mrezamostafavi/Sunshine-Recorder/Bachelor's-thesis-Mostafavi.pdf

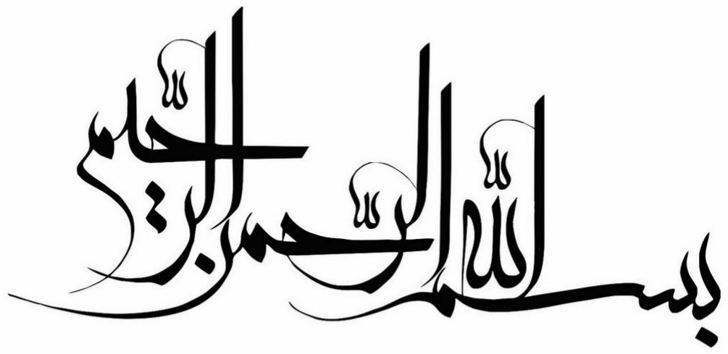
[picture p4: figure]

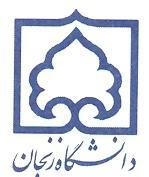
[picture p5: figure]

### پاياننامه کارشناسی

گرايش : الکترونیک

عنوان :
طراحی و ساخت نمونه آزمايشی آفتاب نگار

استاد راهنما : جناب آقای دکتر مهرداد بابازاده

نگارش : محمدرضا مصطفوی

تابستان 1400

# تقدير و تشکر

## شکر شایان نثار ایزد منان که توفیق را رفیق راهم ساخت تا این پایاننامه را به پایان برسانم. از استاد فاضل و اندیشمند جناب آقای دکتر بابازاده به عنوان استاد راهنما که همواره اینجانب را مورد لطف و محبت خود قرار دادهاند، کمال تشکر

را دارم.

خدای را بسی شاکرم که از روی کرم، پدر و مادری فداکار نصیبم ساخته تا در سایه درخت پربار وجودشان بیاسایم و از ریشه آنها شاخ و برگ گیرم و از سایه وجودشان در راه کسب علم و دانش تالش نمایم. والدینی که بودنشان تاج افتخاری است بر سرم و نامشان دلیلی است بر بودنم، چرا که این دو وجود، پس از پروردگار، مایه هستیام بوده اند دستم را گرفتند و راه رفتن را در این وادی زندگی پر از فراز و نشیب به من آموخت ند، آموزگارانی که برایم زندگی، بودن

و انسان بودن را معنا کردند. تقدیم به وجود با ارزششان.

### فهرست مطالب

چکیده 1 |
مقدمه2 |
فصل اول : کلیات تحقی ق 4 |
تاريخچه آفتاب نگار[1]4 |
مزايا و معايب آفتاب نگار کمپبل استوکس 6 |
آفتاب نگار الکتريکی[2]7 |
طرح پیشنهادی 8 |
فصل دوم : تجهیزات مورد استفاده 10 |
بدنه طرح پیشنهادی 10 |
تجهیزات الکترون یکی 15 |
فوتورزيستور15 |
ماژول مالتی پلکسر 16 کاناله16 |
ماژول کارت حافظه17 |
ماژول ساعت 3231DS19 |
آردوينو پرو می نی 20 |
فصل سوم : روش تحقیق 24 |
اتصاالت الکتريکی 24 |
عملکرد کلی پروژه 27 |
برنامه نويسی28 |

حلقه های اصلی28 |
انتخاب برد و پورت28 |
سريال مانیتور 30 |
کتابخانه در آردوينو 31 |
برنامه نوشته ش ده برای آفتاب نگار طراحی شده 32 |
فصل چهارم : يافته های تحقیق 43 |
نتی جه گی ری 46 |
پیشنهادات51 |
مراجع53 |

### فهرست تصاوير

تصویر -1 آفتاب نگار کمپبل استوکس[1]5 |
تصویر -2 نوارها ی استفاده شده در آفتاب نگار کمپبل استوکس6 |
تصویر -3 پیرانومتر[2]8 |
تصویر -4 نمای کلی آفتاب نگار طراح ی شده 9 |
تصویر -5 اجزای بدنه آفتاب نگار طراحی شده 12 |
تصویر -9 فوتورزیستور15 |
تصویر -10 ماژول مالتی پلکسر 16 کاناله 17 |
تصویر -11 ماژول کارت حافظه Card SD18 |
تصویر -12 ماژول ساعت 3231DS19 |
تصویر -13 آردوینو پرو م ینی22 |
تصویر -14 شماتیک آردو ینو پرو مینی[4]23 |
تصویر -15 شماتیک اتصاالت مدار طراحی شده 25 |
تصویر -16 نمایی دیگر از اتصاالت پردازنده و ماژولها25 |
تصویر -17 نحوه اتصال سنسورها و مقاومتها 26 |
تصویر -18 اتصال مالت ی پلکسر به خروج ی سنسورها 26 |
تصویر -19 تکم یل و جداسازی بخش مربوط به سنسورها 27 |
تصویر -20 انتخاب برد آردوینو 29 |
تصویر -21 انتخاب پورت آردوینو29 |
تصویر -22 سریال مانیتور آردوینو30 |
تصویر -23 بخش اول برنامه نوشته شده 32 |
تصویر -24 بخش دوم برنامه نوشته شده33 |
تصویر -25 بخش سوم برنامه نوشته شده 34 |
تصویر -26 بخش چهارم برنامه نوشته شده 35 |

تصویر -27 بخش پنجم برنامه نوشته شده 36 |
تصویر -28 بخش ششم برنامه نوشته شده 37 |
تصویر -29 بخش هفتم برنامه نوشته شده 38 |
تصویر -30 بخش هشتم برنامه نوشته شده 39 |
تصویر -31 بخش نهم برنامه نوشته شده40 |
تصویر -32 بخش دهم برنامه نوشته شده 41 |
تصویر -33 بخش یازدهم برنامه نوشته شده42 |
تصویر -34 نتایج نهایی 16 سنسور43 |
تص ویر -35 نمودار مربوط به سنسورهای 7 و 8 و 15 و 44 | 16
تصویر -36نمونهای از اطالعات نمایش داده شده در سریال مانیتور 45 |
تصویر -37 نمودار مربوط به سنسورهای 7 و 47 | 8

1

### چکیده

با توجه به رو به اتمام بودن منابع انرژی تجدید ناپذیر مانند نفت و گاز و مشکالتی که

استفاده از این انرژیها به وجود آورده است مانند تغییرات اقلیم، آلودگی هوا و تخریب محیط

زیست، استفاده از انواع انرژی تجدیدپذیر ضروری میباشد. انرژی خورشیدی میتواند به طور

مستقیم از خورشید و حتی در آب و هوای ابری به دست آید. انرژی خورشیدی، در سطح

جهان و به صورت گسترده برای تولید برق، گرما و شیرین سازی آب مورد استفاده قرار

میگیرد.

برای اندازهگیری میزان تابش خورشید از دستگاه هایی به نام آفتاب نگار استفاده

میشود. این دستگاهها از گذشته تا کنون شامل تغییرات زیادی شدهاند بگونهای که از شکل

یک کرهی شیشهای به یک دستگاه الکتریکی شامل سنسور رسیده است.

آفتاب نگار طراحی شده شامل 16 سنسور فوتورزیستور است که دور یک حجم گنبدی

شکل قرار داده شدهاند. اطالعات دریافتی از سنسورها با زمان وقوع آنها، از طریق ماژول ها و

قطعات مورد نیاز درون یک کارت حافظه ذخیره میشوند و همچنین به صورت لحظهای

نمایش داده میشوند.

با بررسی اطالعات بدست آمده متوجه دقت مناسب سیستم طراحی شده میشویم،

بهطوری که میتوان تحلیلهای اولیه راجع به وضعیت آب و هوا و میزان روشنایی هوا در روز

آزمایش و همچنین مسیر حرکت خورشد را ارائه نمود.

2

### مقدمه

گستردگی نیاز انسان به منابع انرژی همواره از مسائل اساسی مهم در زندگی بشر بوده

و تالش برای دستیابی به یک منبع تمام نشدنی انرژی از آرزوهای دیرینه انسان بوده است. به

دلیل افزایش روزافزون نیاز به انرژی و محدودیت منابع فسیلی از یک سو و افزایش آلودگی

محیط زیست ناشی از سوزاندن این منابع از سوی دیگر، استفاده از انرژی های تجدیدپذیر را

روز به روز با اهمیتتر و گستردهتر نموده است.

انرژی خورشیدی، نور و گرمای تولید شده توسط خورشید است. انرژی ستاره خورشید

یکی از منابع عمده انرژی در منظومه شمسی میباشد. طبق آخرین برآوردهای رسمی اعالم

شده عمر این انرژی بیش از 14 میلیارد سال میباشد. در هر ثانیه 2.4 میلیون تن از جرم

خورشید به انرژی تبدیل میشود. با توجه به وزن خورشید که حدود 333 هزار برابر وزن زمین

است، این کره نورانی را میتوان به عنوان منبع عظیم انرژی تا 5 میلیارد سال آینده به حساب

آورد.

سالهای زیادی است که اکثر صنعت جهان روی سوخت های فسیلی )زغال سنگ،

نفت و گاز طبیعی( پایدار است. سوختهای فسیلی منابع تجدید ناپذیر هستند، یعنی به وجود

آمدن آنها نیازمند سالهای زیادی است. بنابراین این سوخت ها مدت زیادی نمیتوانند

جوابگوی تمام نیازهای انسان باشند و یک روز تمام خواهند شد. پس باید جایگزین مناسبی

برای این سوخت ها پیدا شود، که انرژی خورشیدی میتواند جایگزین بسیار مناسبی به خصوص

برای نسلهای آینده باشد. بعضی از انرژیها ت أثیر بد و نامطلوبی بر محیط خواهند داشت،

3

مانند سوخت های فسیلی. با بهرهگیری از انرژی خورشیدی، دیگر جای نگرانی نخواهد بود زیرا

اگر منابع انرژی موجود به اتمام برسند، انرژی تجدیدپذیر و دائمی مانند انرژی خورشیدی را

تا ابد خواهیم داشت و تأ ثیرات مخرب زیست محیطی و ایمنی از نظر سالمتی، بشر را تهدید

نخواهد کرد. همچنین خورشید برای زمینه های مختلف به عنوان یک منبع گرمایی و انرژی

استفاده میشود. پرورش محص والت کشاورزی، گرم کردن، خشک کردن مواد غذایی، ذخیره

کردن انرژی در صفحات خورشیدی، نمونهای از این کاربردها هستند.

اولین قدم در راستای استفاده از انرژیهای تجدیدپذیر پس از شناخت آن ها، توانایی

اندازهگیری و همچنین انتخاب محل مناسب جهت بهره برداری حداکثری از آنها است. امروزه

ابزار اندازهگیری مختلفی برای اندازهگیری این انرژیها موجود است که یکی از آنها آفتاب

### 1 نگار

است، که میزان تابش آفتاب را در هر زمان و در یک مکان یا منطقه خاص اندازهگیری

و ثبت میکند.

1
Sunshine Recorder

4

### فصل اول : کلیات تحقیق

تاريخچه آفتاب نگار [1]

### 1 آفتاب نگار کمپبل استوکس

، یکی از انواع آفتاب نگار است. این وسیله نخستین بار

### 2 توسط جان فرانسیس کمپبل

در سال 1853 اختراع و توسط جرج گابریل استوکس

3
در

سال 1879 اصالح شد. طرح اولیه که توسط کمپبل ارائه شده بود؛ متشکل از یک کره شیشهای

بود که درون یک کاسه چوبی قرار گرفته و خورشید با سوزاندن روی کاسه اثر میگذاشت.

اصالح استوکس این بود که نگهدارندهی کره را از فلز ساخت و یک نگهدارنده نوار را در پشت

کره قرار داد تا با سوزانده شدن نوارها بتوان به مدت زمانی که خورشید در آسمان تابیده است،

پی برد. این دستگاه با ایجاد رد سوختگی روی نوار، مدت تابش آفتاب را ثبت میکند.

این وسیله تشکیل شده از یک گوی شیشهای که عملکردی مانند ذرهبین دارد و پرتو

آفتاب را روی صفحهای که در پشت آن قرار دارد متمرکز میکند. محفظه شیشهای کروی

محتوی آب است که خود محفظه در داخل یک کاسه چوبی قرار دارد، محفظه پرتوهای نورانی

خورشید را شبیه به یک عدسی جمع کرده و روی جدار داخلی کاسه چوبی میاندازد. چوب

)یا نوار آفتاب نگار( در اثر پرتو متمرکز شده و گرمای به دس ت آمده از خورشید سوخته و به

تدریج خطی روی آن کشیده میشود.

1 | Campbell–Stokes recorder
2 | John Francis Campbell
3 George Gabriel Stokes

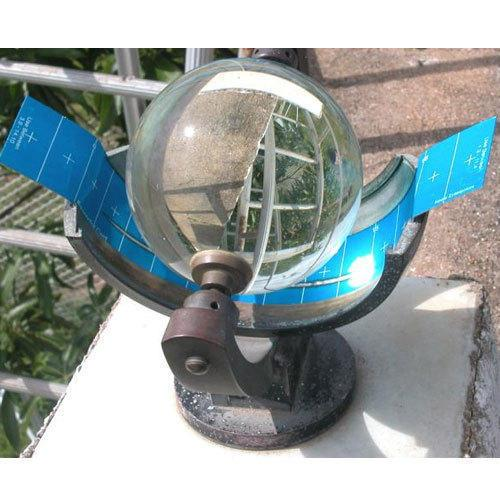
[picture p6: figure]

5

این وسیله رو به جنوب و به صورت کامالً تراز افقی و در ارتفاع 1.5 متری نصب شده

و سپس متناسب با عرض جغرافیایی محل نصب تنظیم میگردد. با توجه به این که در طول

سال زاویه تابش خورشید و طول روز تغییر میکند ، از گرافهای متفاوتی استفاده میشود.

تصویر -1 آفتاب نگار کمپبل استوکس[1]

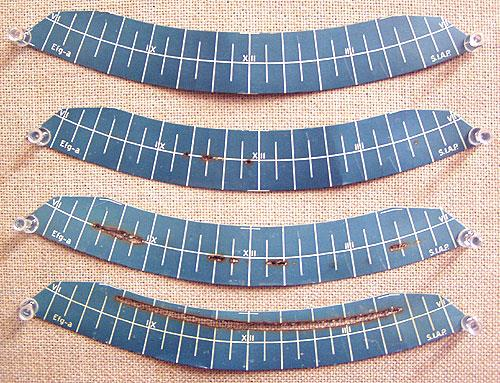
[picture p7: figure]

6

تصویر -2 نوارهای استفاده شده در آفتاب نگار کمپبل استوکس

مزايا و معايب آفتاب نگار کمپبل استوکس

عمدهترین مزیت این نوع آفتاب نگار، سادگی و سهولت استفاده از آن است. هیچ

قسمت متحرکی ندارد، بنابراین به تعمیر و نگهداری بسیار کمی نیاز دارد. این آفتاب نگار را

میتوان در هر کجای دنیا با کمترین تغییر مورد استفاده قرار داد. همچنین این نوع آفتاب

نگار فقط از انرژی خورشیدی استفاده میکند.

هنگامی که تابش خورشید ضعیف باشد، ممکن است قدرت کافی برای سوزاندن

مناسب نوار آفتاب نگار فراهم نشود. این اتفاق اغلب هنگام سحر و غروب رخ میدهد. ممکن

است باران موجب خیس شدن نوار شود و هنگام برداشتن پاره شود و در نتیجه خواندن آن با

7

مشکل مواجه شود. این نوع آفتاب نگار همچنین به عوامل خارجی دیگری همچون گرد و غبار،

آلودگی یا ف ضوالت خشک شده پرندگان روی کره شیشهای و ... حساس است که نیاز به

بازرسی و تمیز کردن مکرر دارد.

آفتاب نگار الکتريکی[2]

همانطور که اشاره شد هنگام استفاده از آفتاب نگار کمپبل استوکس، نیاز است که یک

فرد هر روز نوار استفاده شده را برداشته و تعویض نماید. ممکن است خواندن این نوارها بنا به

دالیل گفته شده در قسمت قبل، با مشکل مواجه شود. همچنین ذخیره کردن تعداد باالی

این نوارها و دسترسی دوباره به آنها کار مشکلی خواهد بود که نیازمند صرف زمان و هزینه

اضافی است. برای حل این مشکالت میتوان از آفتاب نگارهای الکتریکی استفاده نمود. این

نوع آفتاب نگارها برخالف آفتاب نگارهای معمولی که فقط با انرژی خورشیدی کار میکردند،

به یک منبع تغذیه خارجی نیاز دارند.

از جمله این نوع آفتاب نگارها که امروزه مورد استفاده قرار میگیرد میتوان به

### 1 پیرانومتر

اشاره نمود. بطور کلی از پیرانومترها بیشتر برای تحقیقات اقلیمی و اهداف نظارت

بر آب و هوا استفاده میشد، اما عالقه اخیر جهانیان به انرژی خورشیدی، باعث افزایش عالقه

به پیرانومترها شده است.

1 pyranometer

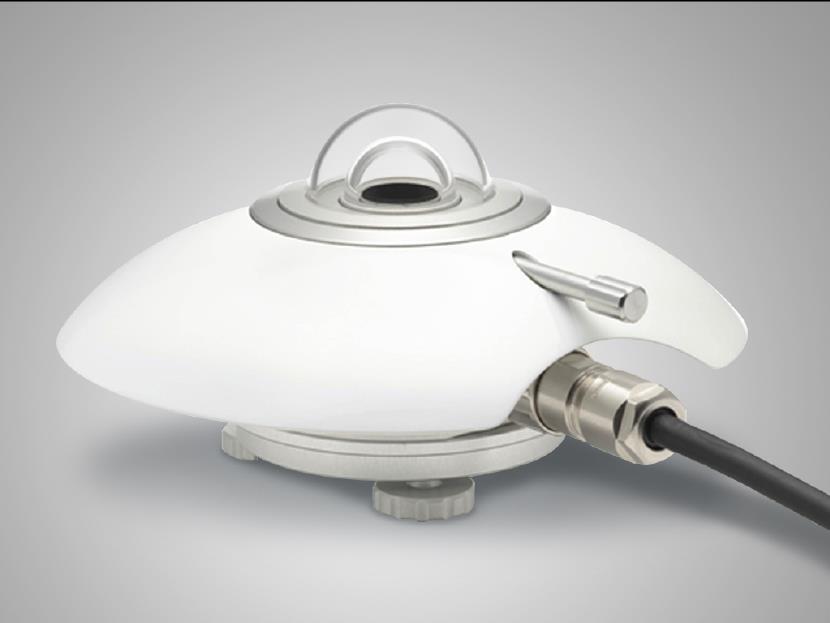
[picture p8: figure]

8

تصویر -3 پیرانومتر[2]

طرح پیشنهادی

همانطور که در بخش های قبل ذکر شد، آفتاب نگارهای الکتریکی مزیتهای بیشتری

نسبت به آفتاب نگارهای معمولی دارند و همچنین قابلیتهای بیشتری نیز می توان به آنها

اضافه نمود. طرحی که در این مطلب به آن پرداخته خواهد شد هم در مجموعه آفتاب نگارهای

الکتریکی قرار میگیرد. مهمترین مزیتی که این طرح را از آفتا ب نگارهای الکتریکی موجود

متمایز میکند، پایین بودن هزینه تمام شده این طرح نسبت به مدلهای دیگر است. در این

طرح سعی بر این بوده است که از سنسورها و قطعات الکترونیکیای استفاده شود که عالوه بر

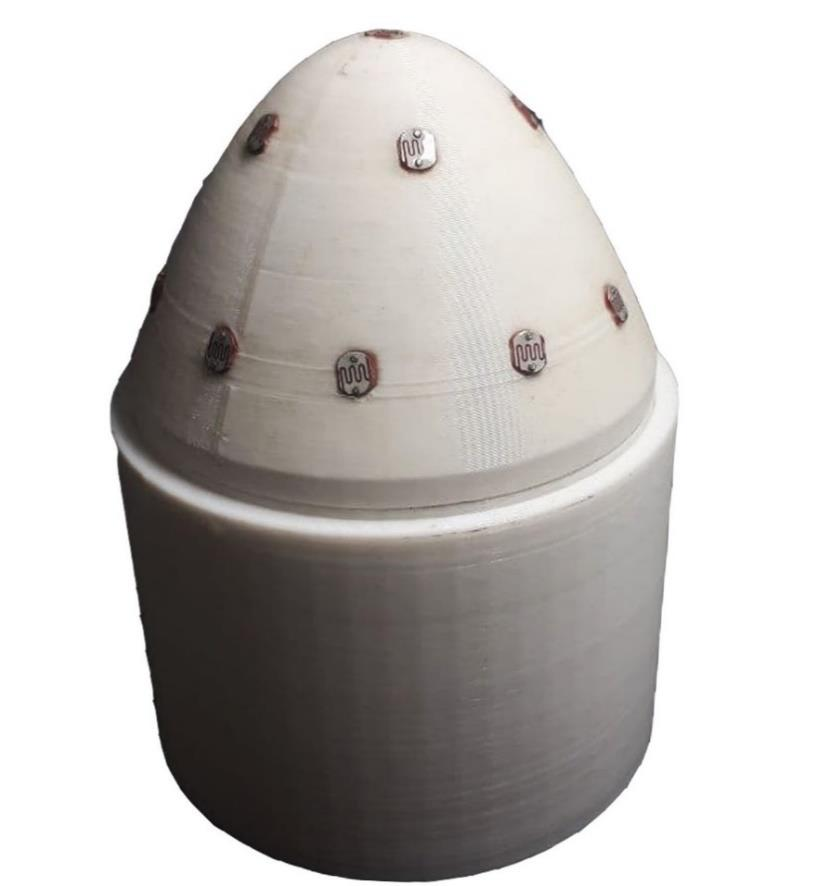
[picture p9: figure]

9

داشتن قیمت پایین، به آسانی قابل دسترس بوده و همچنین از دقت مناسبی نیز برخوردار

باشند. امکان به کارگیری این طرح در تمامی نقاط کره زمین، از جمله اهداف دیگر این طرح

است.

تصویر -4 نمای کلی آفتاب نگار طراحی شده

10

### فصل دوم : تجهیزات مورد استفاده

بدنه طرح پیشنهادی

آفتاب نگار طراحی شده از دو بخش مجزا تشکیل شده است، بخش مربوط به قرارگیری

و اتصاالت سنسورها و بخش مربوط به تجهیزات الکترونیکی که کار پردازش و ذخیره اطالعات

را برعهده دارند. از دالیل جداسازی این دو بخش میتوان به کم کردن اتصاالت نهایی به

پردازنده اصلی و همچنین ایجاد سهولت در تعویض یا تعمیر هر یک از بخشها بدون نیاز به

تغییر در بخش دیگری اشاره نمود.

1 | ابتدا بدنه در نرم افزار سالیدورک
طراحی و سپس با استفاده از پرینترهای سهبعدی،
3 | های PLA | 2 | ساخته شد. برای ساخت بدنه از فیالمنت
که رایج ترین نوع فیالمنت مصرفی در

پرینترهای سهبعدی است، استفاده شده است. PLA، نوعی ترموپالست است که از مواد

ارگانیک نظیر ساقه ذرت و نیشکر تولید میشود. این بنیان طبیعی PLA باعث شده تا موقع

پرینت هیچگونه بوی بدی تولید نکرده، بخار آن سمی نبوده و در پایان با راحتی بیشتری قابل

بازیافت باشد. پرینت PLA به مراتب از دیگر متریالهای فیالمنتی راحت تر است و این نکته

مهمترین دلیل حضور پررنگ این متریال در بازار مواد مصرفی است. از جمله دالیل دیگر که

باعث رایج شدن این نوع فیالمنت شده است، قیمت کمتر و همچنین چاپ آسان و بی دردسر

آن نسبت به انواع دیگر فیالمنتها است.

1
Solidwork

2
Filament
3 Poly Lactic Acid

11

1 | فیالمنت ABS
یکی دیگر از مواد مصرفی رایج در بازار پرینترهای سهبعدی است.

ABS در عین ارزانتر بودن نسبت به بقیه متریالها، دارای استحکام خوبی بوده و نسبت به

فیالمنت PLA منعطفتر است. همین امر باعث شده تا در استفاده نهایی و قرارگیری در

کاالهای مصرفی نقش بیشتری داشته باشد. دو موضوع مهم وجود دارد که بسیاری از کاربران

را از مصرف این نوع فیالمنت باز میدارد. یکی سمی بودن بخار ناشی از ABS در حین چاپ و

دیگری فرایند چاپ آن، که معموال در مقایسه با PLA کمی چالشیتر بوده و نیازمند تجربه

2 | است. شایان ذکر است که حالل ABS، استون
میباشد و می توان از این خاصیت حاللی جهت

پرداخت و پولیش سازه های چاپ شده استفاده کرد. در حالی که حالل PLA ماده سمی

3 کلروفرم

است. این که میبینیم در بازار مواد مصرفی، معموالً PLA پرطرفدارتر از ABS است،

به دلیل استفاده راحتتر و متنوعتر بودن PLA است. تقریباً همه پرینترهای سهبعدی ساخته

شده در دنیا میتوانند PLA را پرینت کنند اما این موضوع برای ABS صادق نیست. [3]

قطعات پرینت شده این طرح از جنس فیالمنت PLA سفید رنگ، در تصویر 4 به

نمایش درآمده است.

1 Acrylonitrile Butadiene Styrene 2 Acetone
3 Chloroform

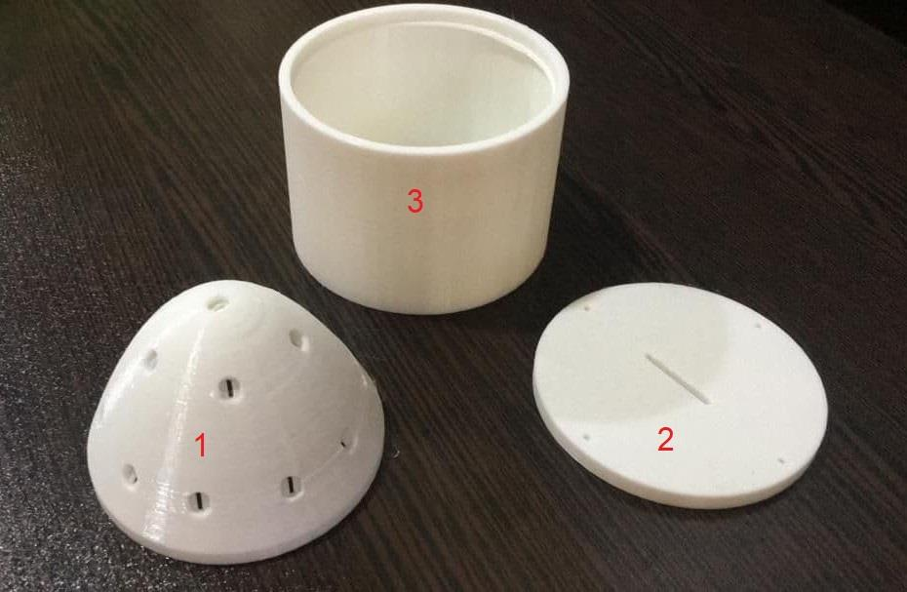
[picture p10: figure]

12

تصویر -5 اجزای بدنه آفتاب نگار طراحی شده

با توجه به تصویر ،5 قطعهای که با شماره 1 مشخص شده است مربوط به بخش

قرارگیری و اتصاالت سنسورها است. روی این قطعه 16 حفره برای قرارگیری سنسورها در

داخل آنها وجود دارد که یکی از این حفره ها در رأس این گنبد و مابقی دور تا دور آن ایجاد

شدهاند که با یکدیگر 24 درجه فاصله دارند. همانطور که مشاهده میشود این قطعه به صورت

سهمیگون است، درحالی که اگر بصورت نیم کره طراحی میگردید ارتفاع قطعه پایین آمده

و سنسورها به هم نزدیک تر میشدند و در نتیجه تفکیک اطالعات آنها دشوار میشد و برای

زیاد کردن فاصله بین آنها باید قطر این نیم کره افزایش پیدا میکرد که نتیجهای جز افزایش

حجم کلی دستگاه نداشت. قطعهای که با شماره 2 مشخص شده است، به زیر قطعه شماره 1

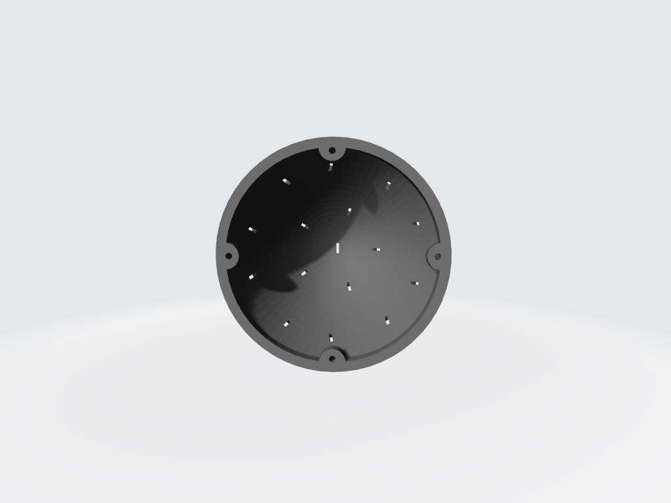
[picture p11: figure]

13

متصل میشود تا آن را از قطعه شماره 3 جدا کند. در این قطعه یک حفرهای وجود دارد تا از

آنجا 8 پایه خارج شود که بتوان اطالعات سنسورها را توسط آنها دریافت کرد. همچنین این

قطعه وظیفه اتصال قطعه شماره 1 با قطعه شماره 3 را به عهده دارد. قطعهای که با شماره 3

مشخص شده است، محل قرارگیری تجهیزات الکترونیکی و ذخیره کننده اطالعات است.

تصویر -6 نمای داخلی قطعه شماره 1

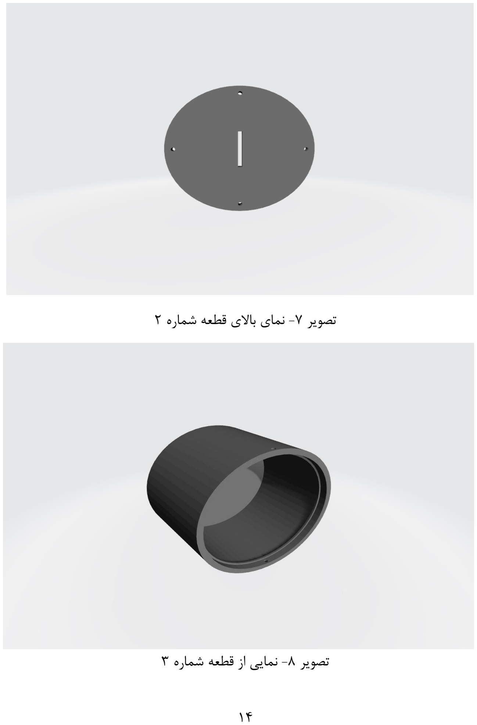
[picture p12: page 21]

14

تصویر -7 نمای باالی قطعه شماره 2

تصویر -8 نمایی از قطعه شماره 3

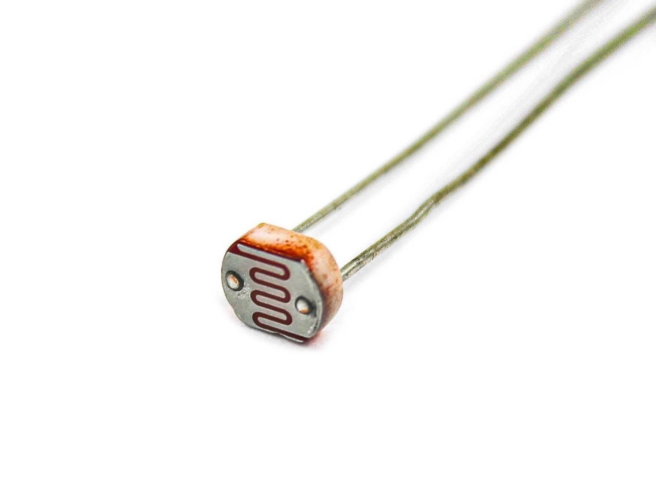
[picture p13: figure]

15

تجهیزات الکترونیکی

1 | فوتورزيستور

سنسورهای فوتورزیستور نوعی از مقاومتها هستند. همانگونه که از اسم آن میتوان

فهمید، به نور حساس است و با تغییر میزان نور مقدار مقاومت نیز تغییر میکند. با روشنتر

شدن محیط اطراف فوتورزیستور، مقدار مقاومت کاهش یافته و با کاهش نور مقدار مقاومت

افزایش مییابد. مشخصه ی خروجی این سنسور به صورت غیرخطی است.

تصویر -9 فوتورزیستور

1 Photoresistor

16

ماژول مالتی پلکسر 16 کاناله

از ماژول مالتی پلکسر 16 کاناله 4067HC74CD میتوان برای زمانی که تعداد زیادی

ورودی آنالوگ در یک مدار وجود دارد، استفاده کرد. در این حالت نیاز است در هر زمان یکی

از آن ورودیها انتخاب شده و پردازش شوند. از این مالتی پلکسر میتوان برای انتخاب از بین

16 ورودی آنالوگ استفاده کرد. برای این منظور 4 پایه 0-3S تعبیه شدهاند که با دادن مقادیر

مناسب به آنها یکی از ورودیهای آنالوگ انتخاب شده و در پایه SIG به عنوان خروجی قرار

میگیرد.

ماژول مالتی پلکسر 16 کاناله 4067HC74CD دارای 24 پایه به شرح زیر است:

- VCC : تغذیه ماژول )5 ولت(
- GND : زمین
- EN : پایه فعال ساز )این پایه Low Active است.(
- 0-3S : انتخاب یکی از 16 پایه ورودی آنالوگ به عنوان سیگنال خروجی نهایی
- 0-15C : ورودیهای آنالوگ
- SIG : سیگنال خروجی

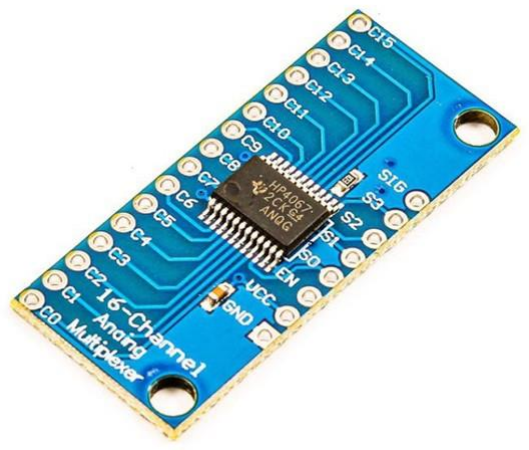
[picture p14: figure]

17

تصویر -10 ماژول مالتی پلکسر 16 کاناله

ماژول کارت حافظه

با استفاده از ماژول کارت حافظه میتوان با کارت حافظه ارتباط برقرار کرد و اطالعات

1 | مورد نظر را از آن خواند و یا بر روی آن نوشت. ارتباط این ماژول از طریق پروتکل SPI

میباشد. حداکثر ظرفیت قابل شناسایی این ماژول برای کارت حافظه مدلSD، دو گیگابایت

و برای مدل SD-Micro، شانزده گیگابایت است. همچنین ماژول کارت حافظه قابلیت استفاده

1
Serial Peripheral Interface

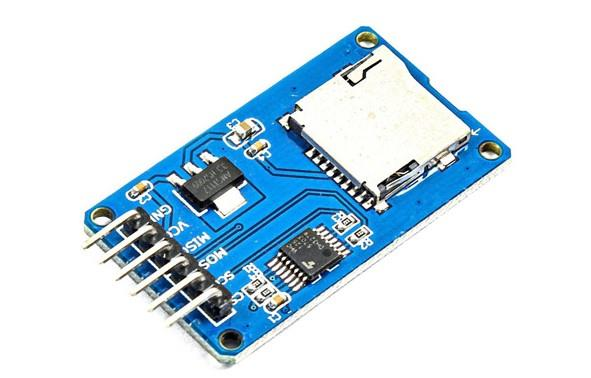
[picture p15: figure]

18

برای کارتهای SD-Micro و SDHC-Micro را دارد و دارای یک رگوالتور 3.3 ولت است

که ولتاژ پایه ها برای اتصال به کارت حافظه را به 3.3 ولت کاهش میدهد.

این ماژول دارای 6 پایه به شرح زیر است:

- VCC : تغذیه ماژول )5 ولت(
- GND : زمین

ChipSelect پایه : CS •

- MISO : پایه فرستنده – معادل پایه Tx پورت سریال
- MOSI : پایه گیرنده – معادل پایه Rx پورت سریال
- SCK : پایه کالک ماژول

تصویر -11 ماژول کارت حافظه Card SD

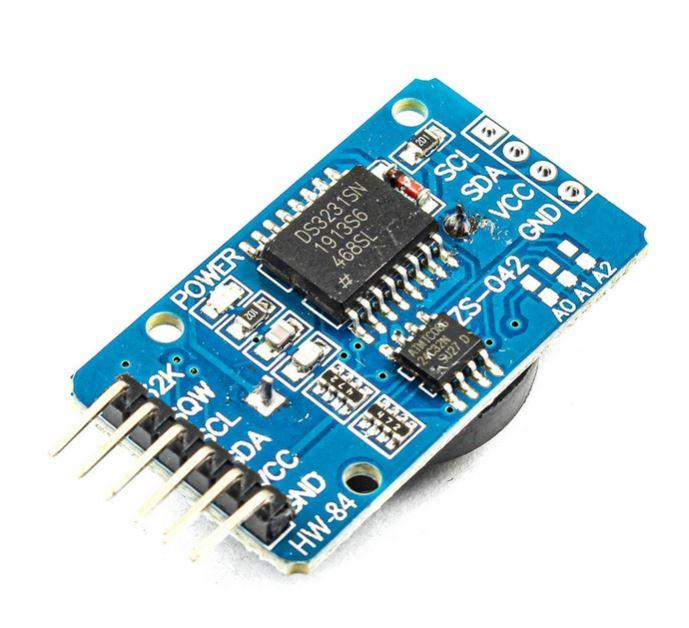
[picture p16: figure]

19

ماژول ساعت 3231DS

ولتاژ کاری این ماژول 3.3 الی 5 ولت بوده و از باتری پشتیبان و جریان مصرفی بسیار

پایین استفاده میکند. باتری پشتیبان قرار گرفته بر روی این ماژول زمانی که برق در دسترس

نیست، از عقب افتادن زمان جلوگیری خواهد کرد. منبع کالک این ماژول از یک کریستال

ساعت به فرکانس 32.768 کیلوهرتز استفاده میکند. این ماژول قابل کارکرد در دو حالت 24

ساعته و 12 ساعته را دارد. همچنین عالوه بر ساعت بصورت ثانیه، دقیقه، ساعت امکان ذخیره

تاریخ بصورت روز، هفته، ماه، سال را نیز دارد.

تصویر -12 ماژول ساعت 3231DS

20

1 | آردوينو پرو مینی

آردوینو، یک پلتفرم متن باز است که در ساخت پروژههای الکترونیکی مورد استفاده

قرار میگیرد. با توجه به طراحی متن باز این پلتفرم، نرمافزار و طرح سختافزار آن به صورت

آزاد در اختیار تمام افراد قرار گرفته و افراد میتوانند به وسیله آن پروژه های الکترونیکی خود

را به سادگی انجام دهند. این ویژگی پلتفرم آردوینو باعث شده تا افراد زیادی در سراسر جهان

از این پلتفرم استفاده کنند و روز به روز بیشتر آن را توسعه دهند. مزیتی که به واسطه رایگان

بودن پلتفرم آردوینو به وجود آمده این است که معموالً هر کسی در هر کجای جهان یک مدار

مکمل به نام شیلد، برای انجام یک کار خاص در آردوینو طراحی میکند و معم والً کتابخانهای

برای این شیلد مینویسد و اغلب اوقات این کتابخانه ها به صورت رایگان با سایر افراد به اشتراک

گذاشته میشود. این ویژگی منحصر به فرد باعث شده تا هر ماژول، سنسور یا قطعهای قابلیت

اتصال به آردوینو را داشته و بتوان صدها کتابخانه برای آن پیدا کرد.

آردوینو شامل یک مدار قابل برنامهریزی فیزیکی )اغلب به عنوان یک میکروکنترلر( و

یک قطعه نرمافزاری یا محیط یکپارچه توسعه )IDE )است که بر روی کامپیوتر اجرا میشود.

IDE ²

محیطی عمدتاً گرافیکی است که تمام یا شماری از ابزارهای الزم برای توسعه نرمافزار

را در خود دارد. در IDE، دسترسی به ابزارها و اعمال آنها در پروژه جاری تسهیل شده است.

برد های آردوینو در بین افرادی که در حوزه الکترونیک فعالیت میکنند بسیار محبوب است.

1 Arduino Pro Mini

2
Integrated Development Environment

21

به این دلیل که برخالف بسیاری از بردهای قابل برنامهریزی، آردوینو برای بارگذاری کدهای

جدید بر روی برد، به سختافزار جداگانه نیاز ندارد و میتوان به راحتی با استفاده از یک کابل

USB این کار را انجام داد.

آردوینو پرو مینی یک برد آردوینو بر پایه میکروکنترلر 328ATmega میباشد و به

لحاظ کارایی و عملکرد کامال مشابه با سایر بردهایی که از این نوع میکروکنترلر استفاده

میکنند بوده و تنها تفاوت این برد در شکل فیزیکی آن میباشد. در این برد به منظور کاهش

سایز ورودی آداپتور و پورت USB( که در اکثر پروژه ها کاربرد دائمی نداشته( حذف شده

است. در نتیجه برای انجام پروژههایی با سایز کوچک و همین طور در رباتهای پرنده و یا

هواپیماهای مدل که وزن و اندازه اجزای آن بسیار حائز اهمیت است، توصیه میگردد. از طرفی

حذف پورت USB در این مدل برد موجب شده تا نتوان به سادگی سایر بردهای آردوینو، کدها

را بر روی برد آپلود نمود و برای این کار الزم است کد را از طریق کابلها و مبدلهای USB

به سریال و یا از طریق یک برد آردینو دیگر که دارای رابط USB میباشد به عنوان پروگرامر

استفاده نموده و کدها را درون میکروی برد آپلود کرد.

از دالیل انتخاب این برد برای آفتاب نگار طراحی شده، میتوان به قیمت پایین آن و

همچنین ابعاد کوچک آن اشاره نمود که تمامی وِیژگیهای الزم برای این پروژه را شامل

میشد و همچنین از قطعات اضافی که روی بردهای دیگر وجود دارد و در این پروژه ضروری

نبود صرف نظر شده است.

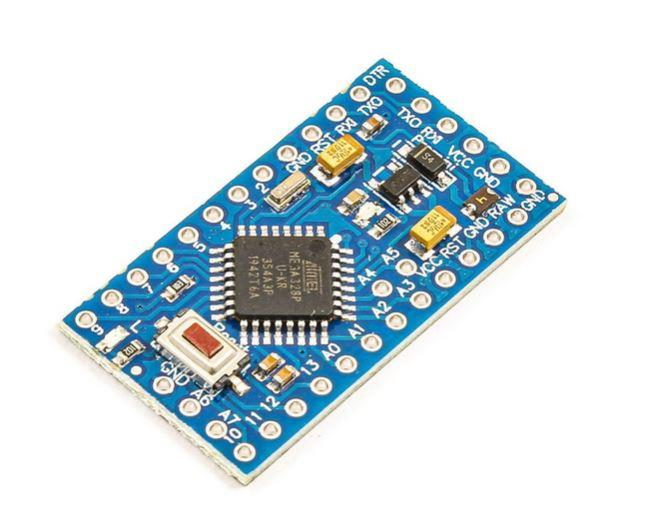
[picture p17: figure]

22

مشخصات فنی آردوینو پرو مینی :

- ولتاژ کاری برد : 3.3 ولت
- پین های ورودی/خروجی دیجیتال : 14
- پین ه ای ورودی/خروجی آنالوگ : 8
- جریان DC هر پین ورودی/خروجی : 40 میلی آمپر
- فرکانس کالک : 8 مگاهرتز

تصویر -13 آردوینو پرو مینی

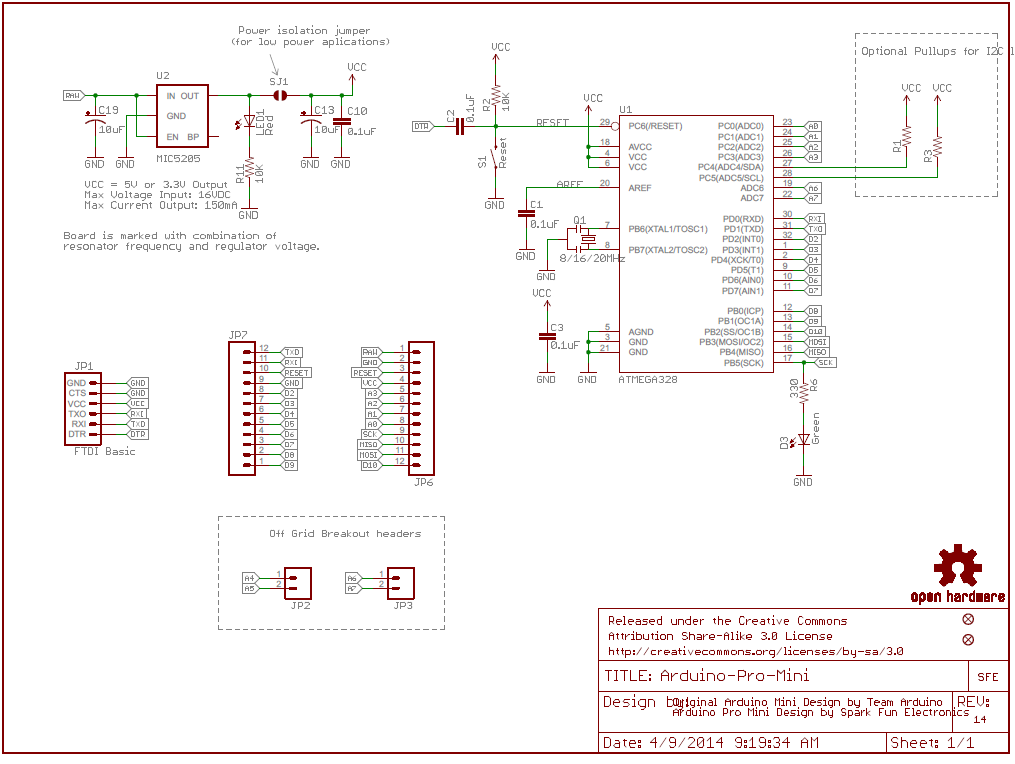
[picture p18: figure]

23

تصویر -14 شماتیک آردوینو پرو مینی[4]

24

### فصل سوم : روش تحقیق

اتصاالت الکتريکی

برای خواندن مقدار فوتورزیستورها، از تقسیم ولتاژ استفاده میکنیم. به این گونه که

یک پایه فوتورزیستور را به VCC و پایه دیگر آن را توسط یک مقاومت 1 کیلو اهم به زمین

متصل میکنیم. از محل اتصال فوتورزیستور و مقاومت مقدار ولتاژ را توسط پایه آنالوگ

پردازنده میخوانیم. با توجه به این که در آفتاب نگار طراحی شده از 16 فوتورزیستور استفاده

شده، اگر بخواهیم همه ولتاژهای تولید شده از این تعداد سنسورها را مستقیماً به پردازنده

متصل کنیم، اوالً باید پردازندهای انتخاب شود که این تعداد پایه آنالوگ داشته باشد که مستلزم

صرف هزینه بیشتری خواهد بود و ثانیاً با توجه به اینکه محل قرارگیری سنسورها از پردازنده

فاصله دارند، نیازمند فضای بیشتری بود و همچنین کنترل آنها به دلیل درهم پیچیده شدن

اتصاالت ، دشوار میشد. برای جلوگیری از معضالت ذکر شده، از مالتی پلکسر 16 کاناله استفاده

شده است که با مقداردهی به پایههای کنترلی آن میتوان تمام خروجی سنسورها را در نهایت

توسط یک پایه به پردازنده انتقال داد. استفاده از مالتی پلکسر به کاهش ابعاد طرح و همچنین

کنترل بهینه آن کمک شایانی کرده است.

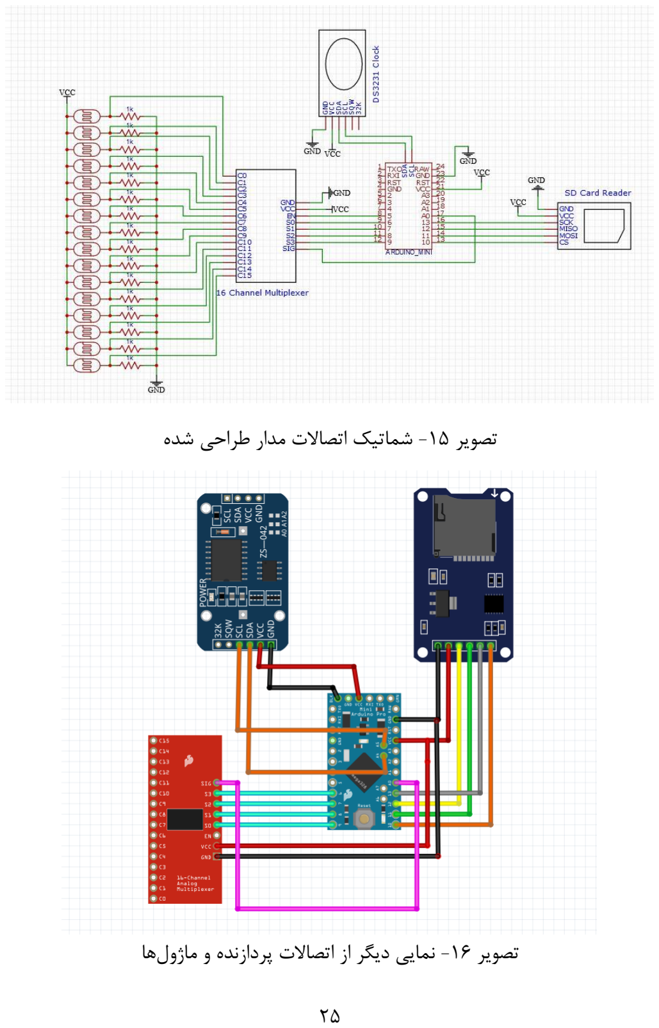
[picture p19: page 32]

25

تصویر -15 شماتیک اتصاالت مدار طراحی شده

تصویر -16 نمایی دیگر از اتصاالت پردازنده و ماژولها

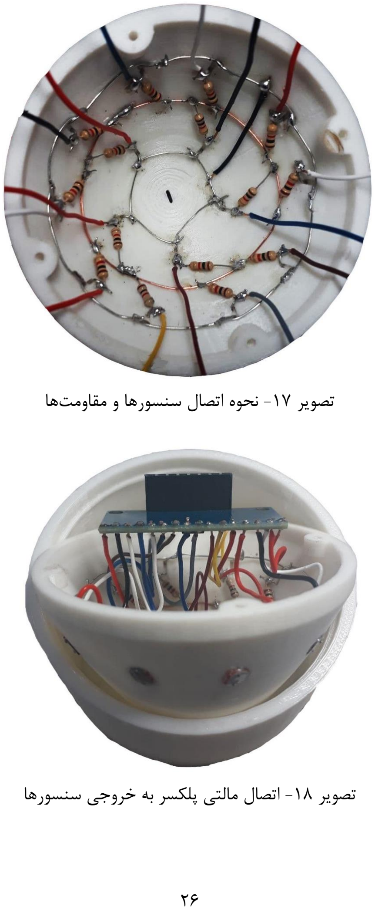
[picture p20: page 33]

26

تصویر -17 نحوه اتصال سنسورها و مقاومت ها

تصویر -18 اتصال مالتی پلکسر به خروجی سنسورها

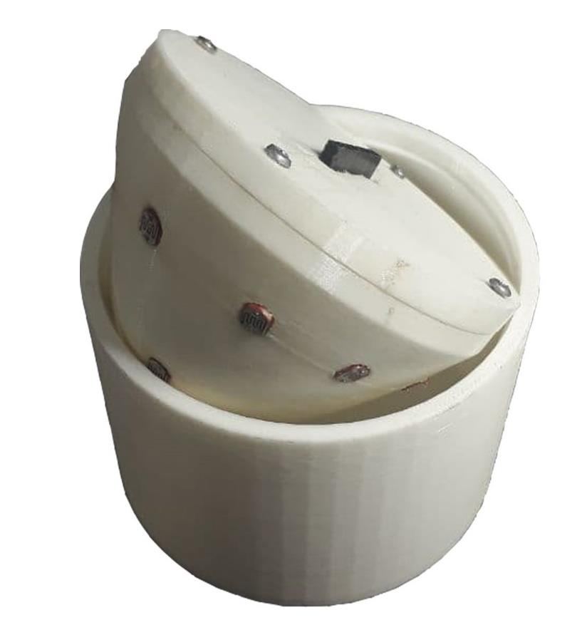
[picture p21: figure]

27

تصویر -19 تکمیل و جداسازی بخش مربوط به سنسورها

عملکرد کلی پروژه

هدف از این سیستم، نمونه برداری از مقدار روشنایی محیط توسط خورشید در

زمانهای مختلف از یک شبانه روز است. هرچه تعداد این نمونهها بیشتر باشد، در نتیجه فاصله

زمانی بین نمونهها کمتر بوده و دادههای نهایی از دقت بیشتری برخوردار خواهند بود. کارکرد

این طرح به این گونه است که هرچند دقیقه یکبار )با توجه به دقت مورد نیاز( اطالعات همه ی

16 سنسور به نوبت توسط مالتی پلکسر به پردازنده انتقال داده شده و همراه با ساعت و دقیقه

آن لحظه که توسط ماژول ساعت دریافت میشود، توسط ماژول کارت حافظه در کارت حافظه-

ای که درون آن قرار گرفته ذخیره میشود و در سریال مانیتور نمایش داده میشوند.

28

برنامه نويسی

با توجه به اینکه از آردوینو به عنوان سیستم پردازنده استفاده شده است، بهترین

انتخاب برای برنامه نویسی زبان C و همچنین در محیط IDE Arduino خواهد بود.

حلقه های اصلی
1 | در آردوینو به هر برنامه، یک طرح

گفته میشود. مبنای کدنویسی آردوینو زبان C و

++C است که برای راحتی کار با آن، تا حد زیادی سادهسازی شده است. یک برنامه آردوینو

حداقل شامل دو بخش کلی Setup Void و Loop Void است. در ادامهی هر کدام از این

بخشها دو آکوالد وجود دارد. محتوای هر کدام از این بخشها بین این دو آکوالد تعریف

میشود. Setup مجموعهای از کدها را دربر میگیرد که هر وقت آردوینو به برق متصل شود

یا کلید Reset فشرده شود، تنها یک بار اجرا میشود. Loop مجموعهای از کدها را در خود

دارد که باید بدون وقفه و به صورت تکراری اجرا شوند.

انتخاب برد و پورت
هر زمان که یک برد آردوینو به رایانه متصل شود، قبل از هر چیز باید برد و پور ت

مورد استفاده را به برنامه معرفی کرد. برای این منظور از مسیر Board → Tools مدل و از

مسیر Port → Tools پورتی که آردوینو به آن متصل شده است، انتخاب میشود.

1
Sketch

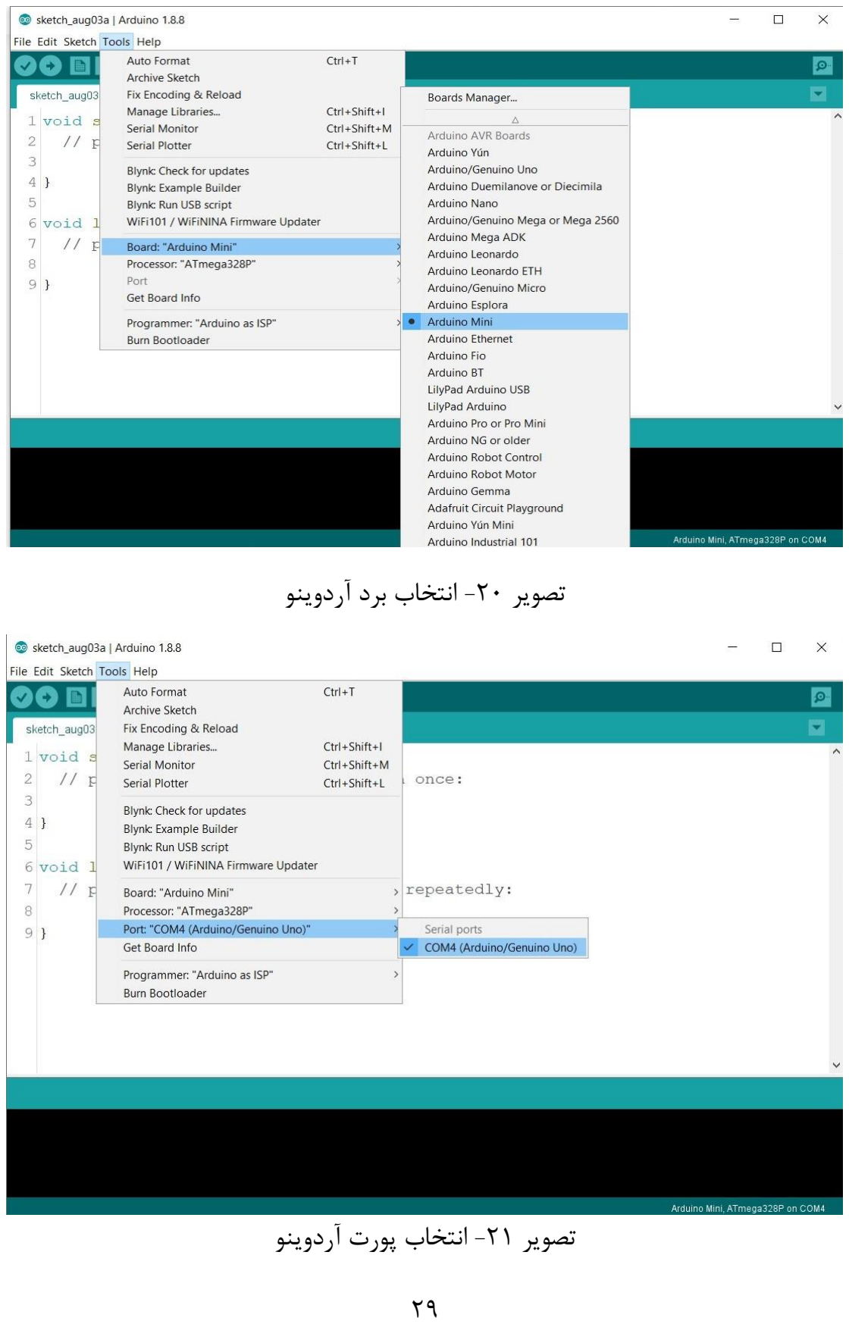
[picture p22: page 36]

29

تصویر -20 انتخاب برد آردوینو

تصویر -21 انتخاب پورت آردوینو

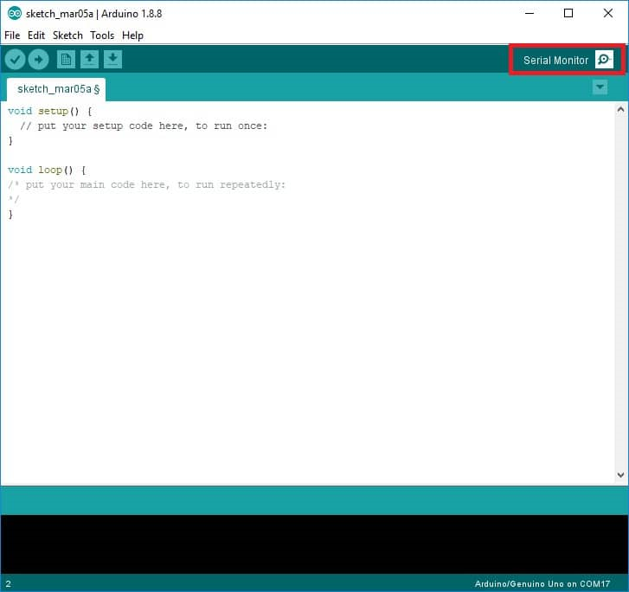
[picture p23: figure]

30

سريال مانیتور
1 | در آردوینو محیطی به نام سریال مانیتور
وجود دارد که در آن میتوان متن مورد نظر

را نمایش داد. کلیدی که در انتهای سمت راست نوار باال وجود دارد پنجره سریال مانیتور را

باز میکند.

تصویر -22 سریال مانیتور آردوینو

1
Serial Monitor

31

در سریال مانیتور میتوان خروجی یک تابع، اطالعات یک ماژول یا ه ر اطالعات دیگری

نوشت. این کار کمک میکند تا از روند اجرای برنامه مطلع شد و بتوان آن را عیبیابی کرد.

عالوه بر آن در نوار باالی سریال مانیتور میتوان یک دستور یا عبارت را به برد ارسال کرد.

برای استفاده از سریال مانیتور کافیست در حلقه setup دستور "(9600)begin.Serial "

را نوشت. عدد درون پرانتز، سرعت دادهبرداری سریال را نشان میدهد و میتوان مقدار آن را

عوض کرد.

کتابخانه در آردوينو
کتابخانهها مجموعهای از تعاریف و توابع هستند که یک بار برای همیشه نوشته

میشوند و از آن پس، فقط مورد استفاده قرار میگیرند. استفاده از کتابخانه، حجم کد نوشته

شده را کم کرده، برنامه خواناتر و قابل فهمتر شده و منابع سختافزاری کمتری استفاده

میکند.

سادهترین راه برای نصب یک کتابخانه، دانلود آن با خود نرمافزار است. برای این کار

کافیست به مسیر Libraries Manage → Library Include → Sketch رفته و پس

از مشاهده لیست کتابخانه ها، عنوان کتابخانه را جستجو کرده و با کلیک بر روی گزینه install

کتابخانه موردنظر را نصب کرد.

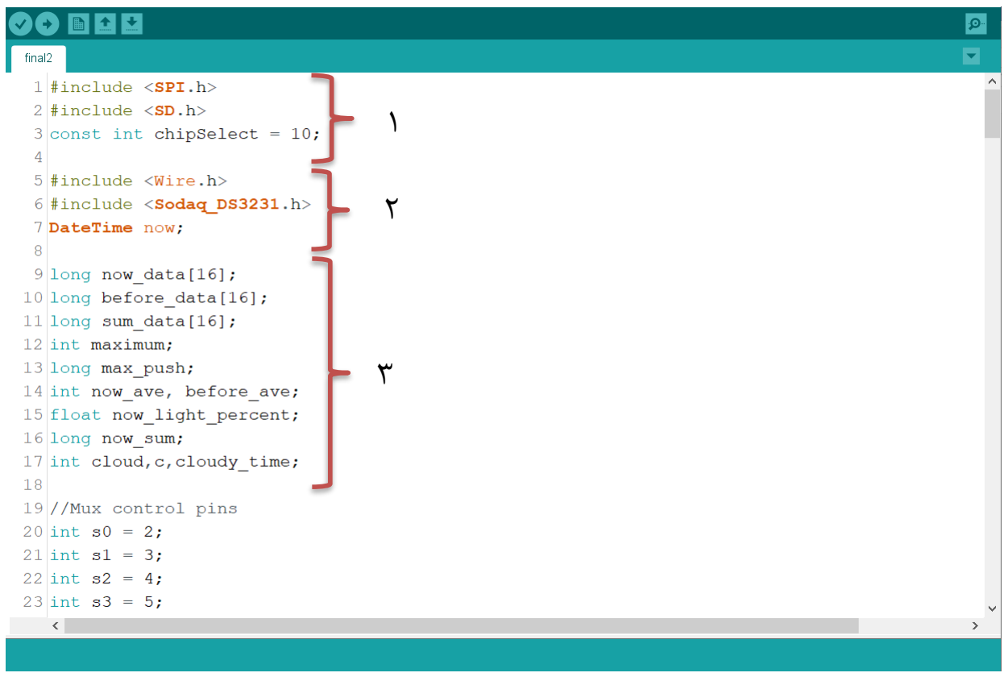
[picture p24: figure]

32

برنامه نوشته شده برای آفتاب نگار طراحی شده کل برنامه نوشته شده و توضیح خطوط آن در ادامه ذکر شده است.

تصویر -23 بخش اول برنامه نوشته شده

-1 کتابخانههای SPI و SD جهت استفاده از پروتکل SPI و همچنین استفاده از ماژول

کارت حافظه فراخوانی میشود. و سپس عنوان chipSelect به پایه 10 نسبت داده

میشود.

-2 در این بخش کتابخانههای مورد نیاز جهت راهاندازه ماژول ساعت فراخوانی میشود.

-3 در سه خط اول این بخش، سه آرایه با طول 16 تعریف شده است. در ادامه نیز

متغیرهایی تعریف شدهاند که به آنها برای ذخیره سازی اطالعات نیاز خواهیم داشت.

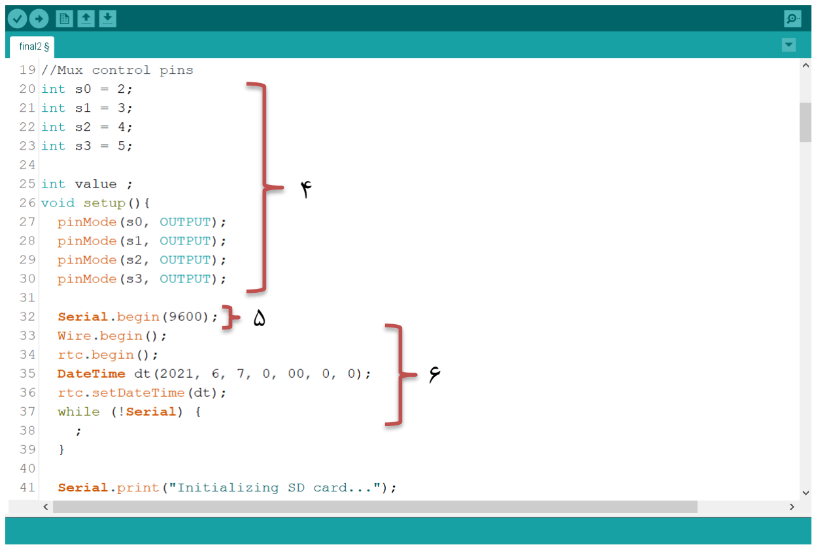
[picture p25: figure]

33

تصویر -24 بخش دوم برنامه نوشته شده

-4 ابتدا عناوین 0S، 1S، 2S و 3S به ترتیب به پایههای ،2 ،3 4 و 5 نسبت داده شده و

در ادامه این پایهها به عنوان پایه های خروجی تعریف شدهاند. از این پایهها برای کنترل

این که کدام ورودی به خروجی انتقال داده شود، استفاده میشود.

-5 در این بخش سرعت بادریت

1
برای نمایش همزمان اطالعت دریافت شده در قسمت

سریال مانیتور برنامه در صورت متصل بودن کامپیوتر به آردوینو، تعیین می شود..

-6 تنظیمات اولیه مربوط به ماژول ساعت )سال، ماه، روز، ساعت، دقیقه، ثانیه( در این

بخش انجام میگیرد.

1 Baud rate

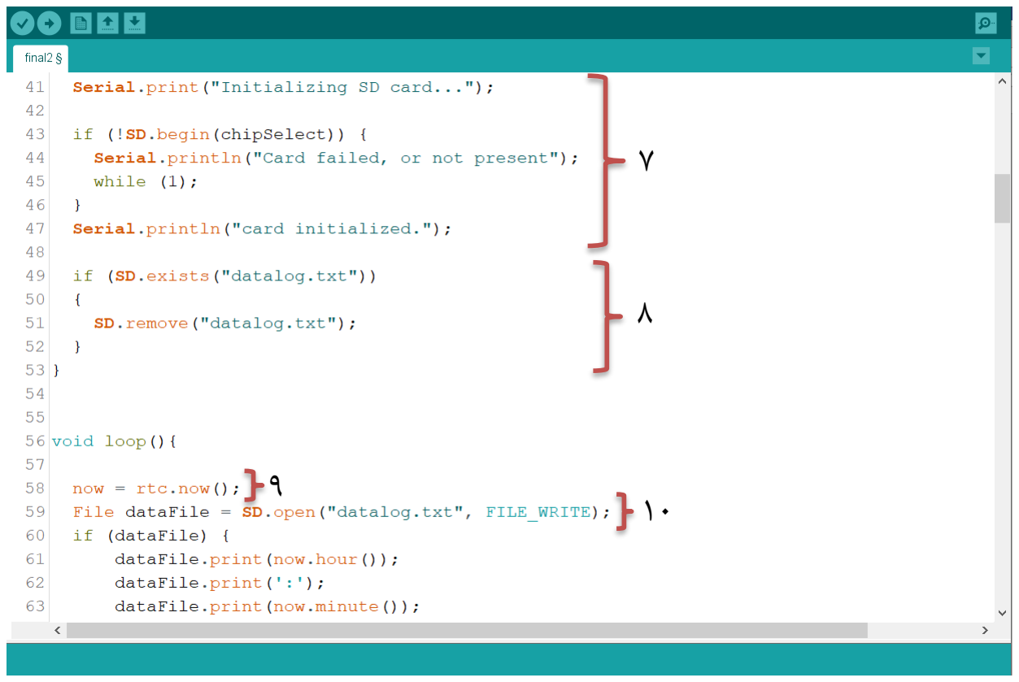
[picture p26: figure]

34

تصویر -25 بخش سوم برنامه نوشته شده

-7 موفقیت یا عدم موفقیت در راهاندازی و تشخیص کارت حافظه توسط این خطوط در

مانیتور سریال نمایش داده خواهد شد.

-8 در این بخش فایلی به نام datalog جهت ذخیره اطالعات دریافتی ایجاد و در کارت

حافظه ذخیره میشود.

-9 در این خط زمان از ماژول ساعت دریافت و در متغیر now ذخیره میشود.

-10 با استفاده از این دستور فایلی که در کارت حافظه ساخته شده بود، باز شده و آماده

نوشته شدن خواهد بود.

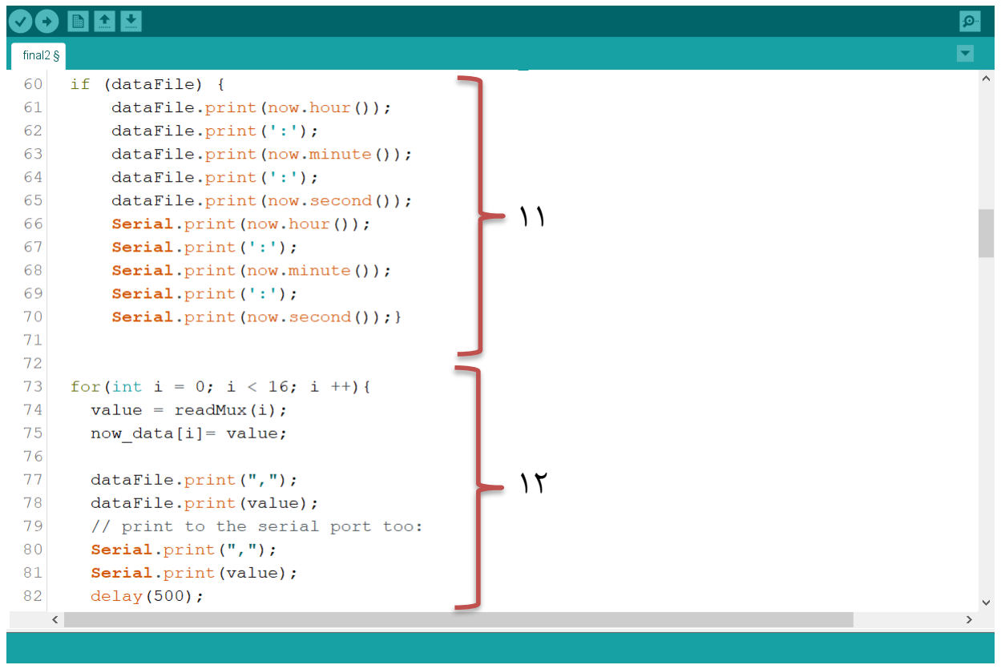
[picture p27: figure]

35

تصویر -26 بخش چهارم برنامه نوشته شده

-11 در این بخش ساعت، دقیقه و ثانیه به ترتیب ابتدا در کارت حافظه ذخیره و سپس در

مانیتور سریال نمایش داده میشوند.

-12 در این بخش یک حلقه ایجاد شده است که قرار است 16 بار )به تعداد سنسورها(

تکرار شود، بهطوری که هر بار شماره سنسور را به تابع readMux فرستاده و مقدار

آن سنسور را دریافت میکند. سپس ابتدا آن را در آرایهای به نام data_now ذخیره

کرده و در ادامه در کارت حافظه ذخیره و پس از آن در مانیتور سریال نمایش میدهد.

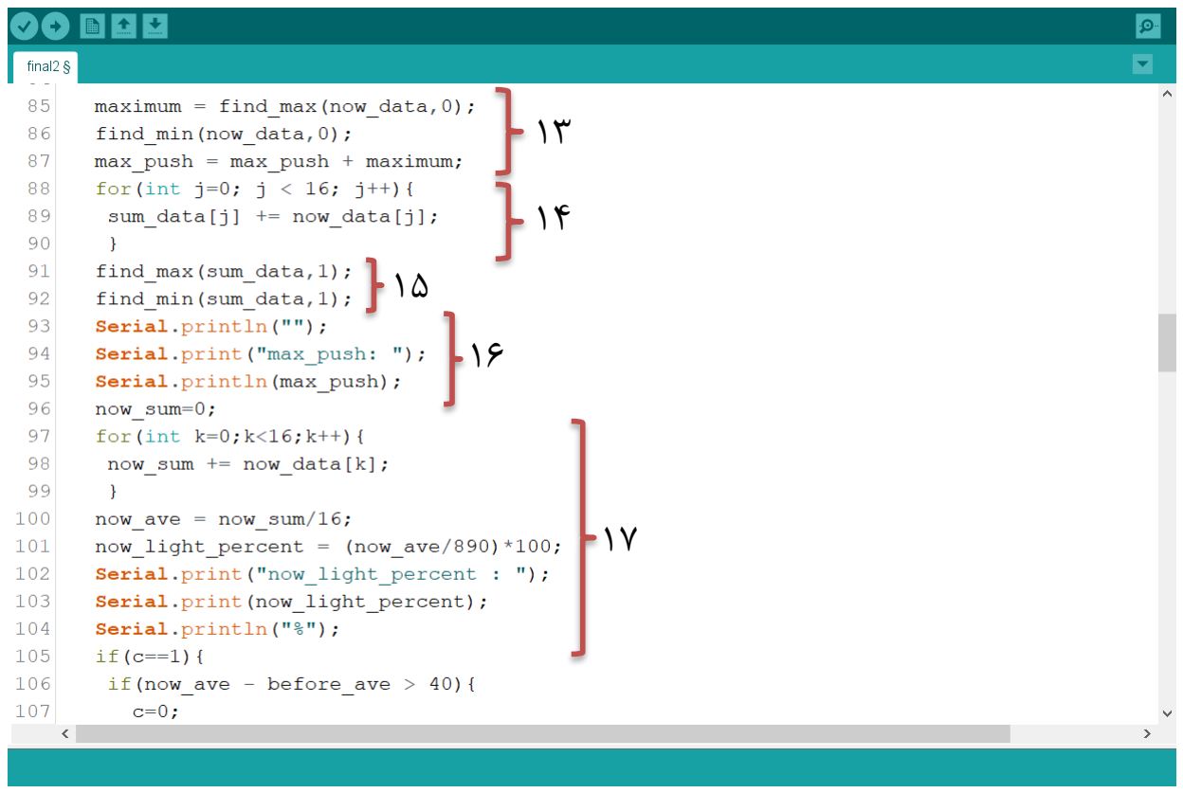
[picture p28: figure]

36

تصویر -27 بخش پنجم برنامه نوشته شده

-13 آرایه data_now به دو تابع max_find و min_find فرستاده شده و سپس

مقدار maximum برگشت داده شده توسط تابع max_find با مقدار قبلی متغیر

push_max جمع شده و دوباره در متغیر push_max قرار میگیرد.

-14 با استفاده از این حلقه بعد از هر نوبت اندازهگیری اطالعات، مقدار هر سنسور با مقادیر

گذشته خود جمع شده و در متغیر data_sum ذخیر میشود.

-15 متغیر data_sum به دو تابع max_find و min_find فرستاده میشود.

-16 مقدار جدید متغیر push_max که در بخش 13 به دست آمد، در این بخش در

سریال مانیتور به نمایش در میآید.

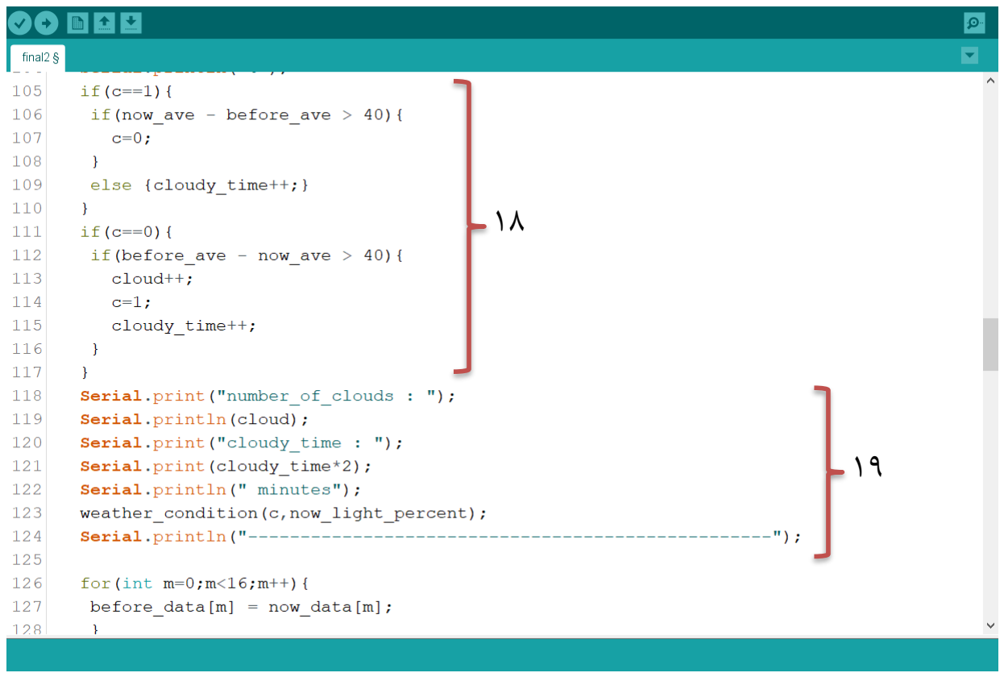
[picture p29: figure]

37

-17 در این بخش ابتدا تمام مقادیر موجود در آرایه data_now با یکدیگر جمع شده و

سپس میانگین آنها محاسبه میشود. چون بیشترین مقداری که میتوان دریافت کرد

890 است، با تقسیم مقدار میانگین به دست آمده بر این عدد و سپس ضرب آن در

،100 درصد آرایه data_now به دست میآید. در آخر درصد به دست آمده از طریق

سریال مانیتور به نمایش در میآید.

تصویر -28 بخش ششم برنامه نوشته شده

-18 در این بخش با توجه به مقادیر ave_now و ave_before میتوان به وجود سایه

توسط ابر پی برد. اگر مقدار c برابر 1 باشد به این معنی است که هم اکنون خورشید

پشت ابر قرار دارد و اگر مقدار c برابر صفر باشد، به این معنی است که هیچ ابری

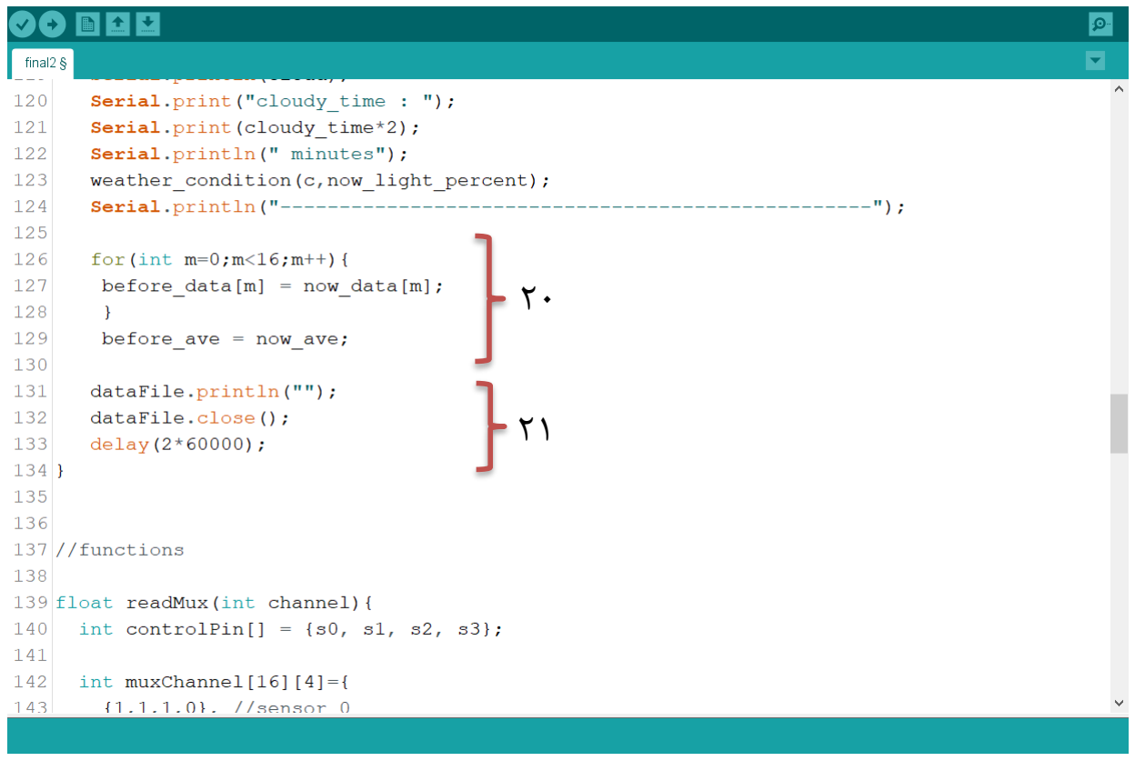
[picture p30: figure]

38

جلوی خورشید نیست. متغیر time_cloudy مدت زمان وجود ابر جلوی خورشید

را اندازه میگیرد.

-19 ابتدا مقادیر محاسبه شده در بخش قبل، در سریال مانیتور نمایش داده میشوند و

سپس مقادیر c و percent_light_now که در بخش 17 محاسبه شده بود، به

تابع condition_weather ارجاع داده میشوند. و در آخر خطی برای جداسازی

اطالعات این نوبت اندازهگیری با نوبت دیگر رسم میشود.

تصویر -29 بخش هفتم برنامه نوشته شده

-20 در این بخش ابتدا مقادیر آرایه data_now به آرایه data_before انتقال داده

شده و سپس مقدار ave_now به ave_before منتقل میشود.

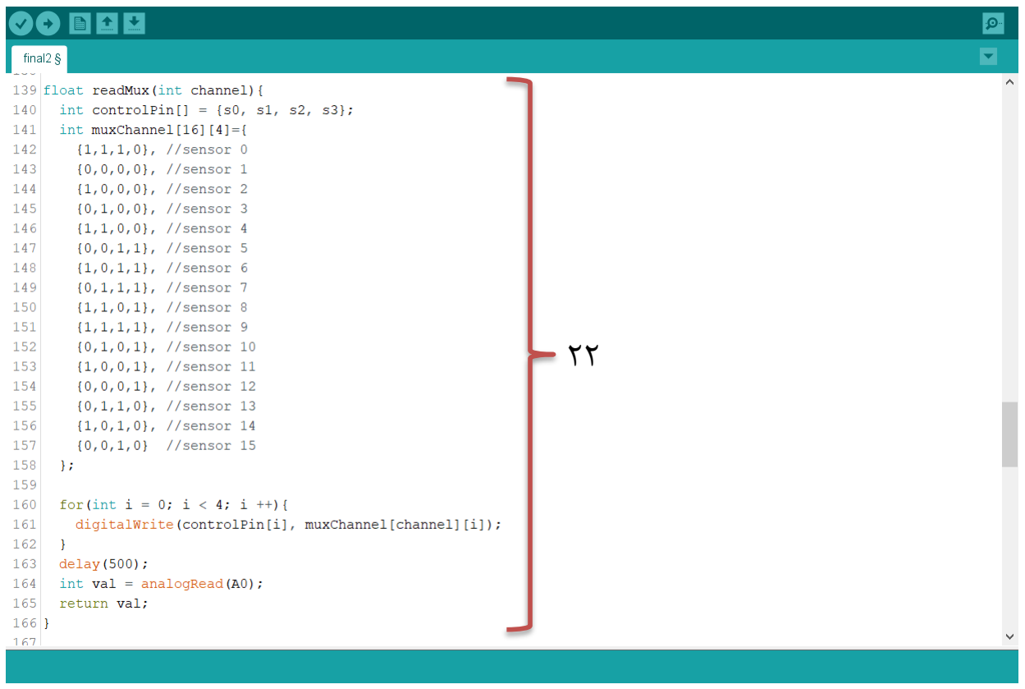
[picture p31: figure]

39

-21 فایلی که در بخش 8 باز شده بود، بسته میشود و در آخر به مدت 2 دقیقه وقفه

صورت میگیرد.

تصویر -30 بخش هشتم برنامه نوشته شده

-22 در این بخش تابعی به نام readMux تعریف شده است. همانطور که از نام تابع

مشخص است، وظیفه کنترل مالتی پلکسر را برعهده دارد. کارکرد این تابع به این گونه

است که ابتدا شماره سنسوری که مقدار آن مدنظر است را دریافت کرده، سپس با

توجه به شماره سنسور مقادیر 0-3S را طوری مقدار دهی میکند که مالتی پلکسر

مقدار آن سنسور مشخص شده را به خروجی هدایت کند. در نهایت این مقدار خروجی

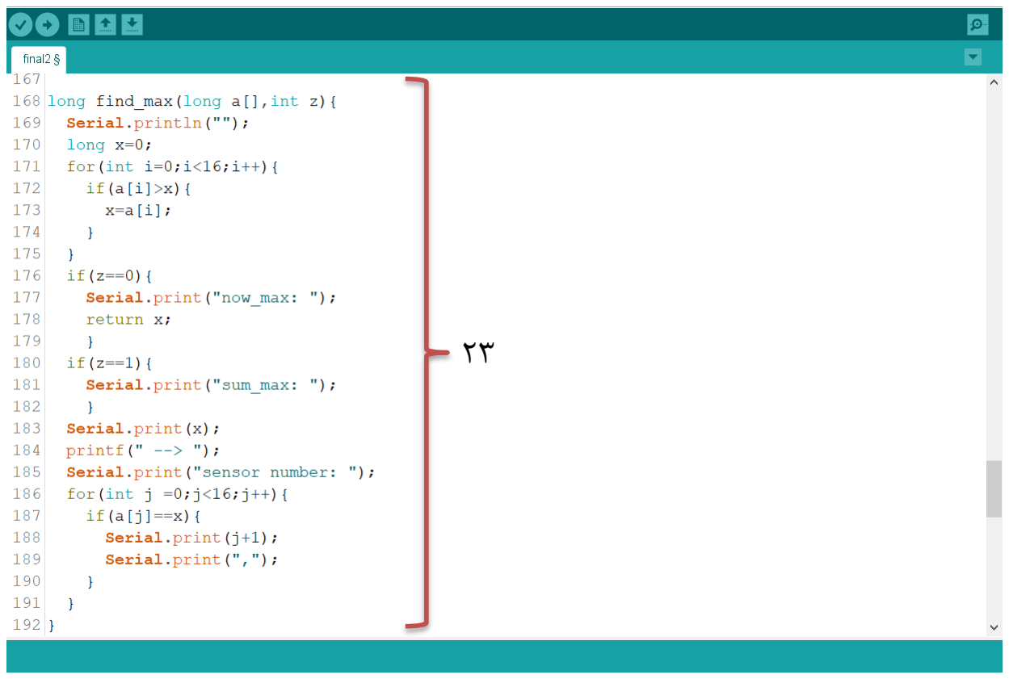
[picture p32: figure]

40

در متغیری به نام val ذخیره شده و به محلی که این تابع فراخوانی شده است، برگشت

داده میشود.

تصویر -31 بخش نهم برنامه نوشته شده

-23 این بخش مربوط به تعریف تابع max_find است. این تابع دو ورودی دارد که یکی

از آنها آرایه بوده و دیگری یک متغیر است که مقدار آن صفر یا 1 خواهد بود. از اسم

تابع مشخص است که وظیفه آن پیدا کردن بیشترین مقدار موجود در آرایه ارسالی به

آن است. دیگر ورودی این تابع صرفاً این وظیفه را دارد مشخص کند که آرایه ارسال

شده به تابع، data_now است یا data_sum تا در نمایش اطالعات عناوین به

درستی در سریال مانیتور نمایش داده شوند.

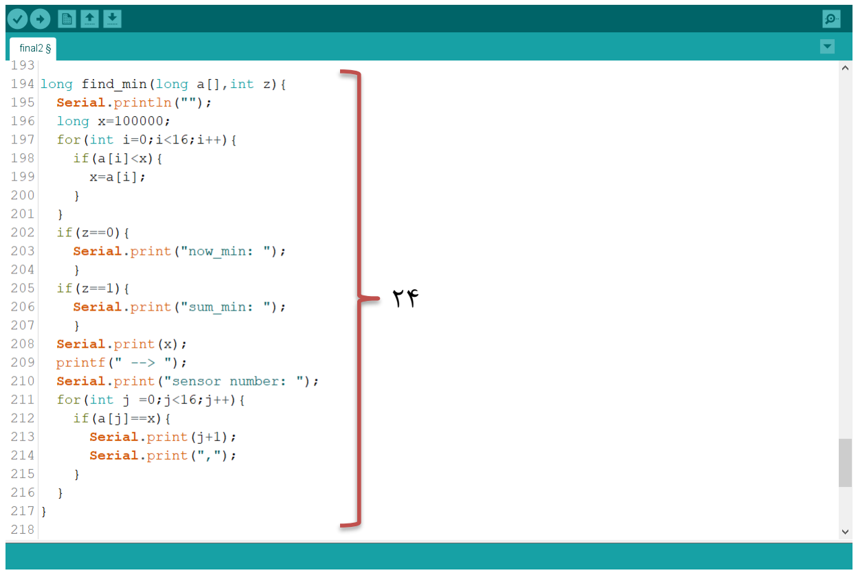
[picture p33: figure]

41

تصویر -32 بخش دهم برنامه نوشته شده

-24 در این بخش تابع min_find تعریف شده است. اطالعات و عملکرد این بخش مانند بخش قبل است با این تفاوت که در این تابع کمترین مقدار آرایه ارسال شده به آن تعیین شده و در سریال مانیتور نمایش داده میشود.

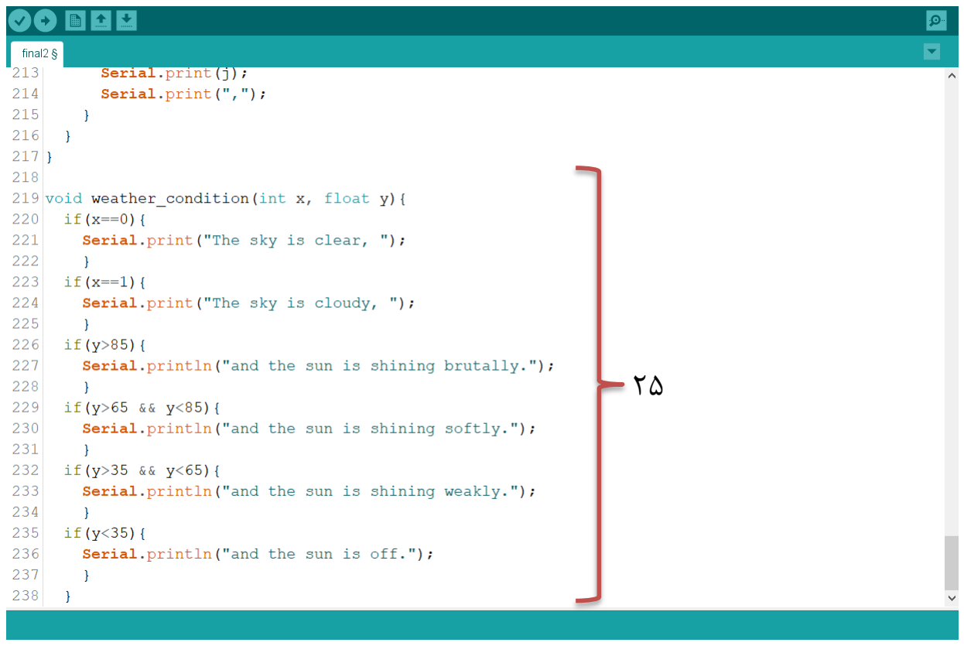
[picture p34: figure]

42

تصویر -33 بخش یازدهم برنامه نوشته شده

-25 این بخش مربوط به تعریف تایع condition_weather است. این تابع دو ورودی

مربوط به وجود یا عدم وجود ابر و مقدار درصد روشنایی حال حاضر را دریافت میکند

و با توجه به مقادیر این دو ورودی، یک جمله توصیفی از وضعیت آسمان و خورشید

بیان میکند.

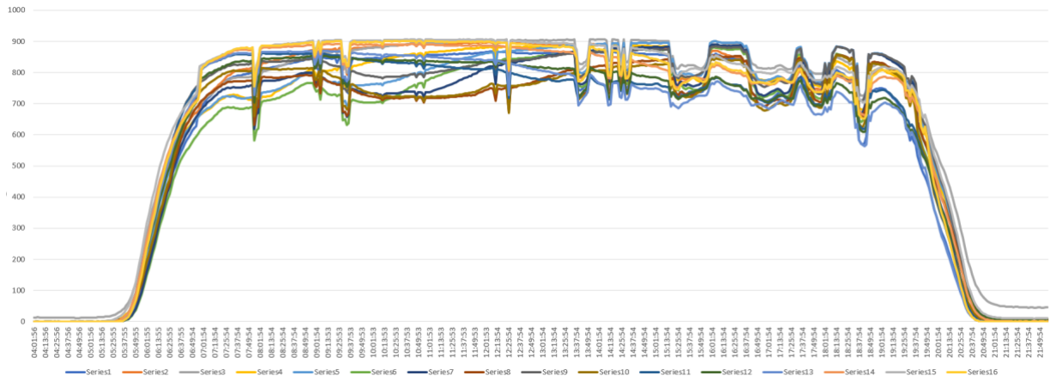
[picture p35: figure]

43

### فصل چهارم : يافته های تحقیق

نحوه تست عملکرد این طرح این گونه بود که چند ساعت قبل از طلوع خورشید و در

تاریکی مطلق سیستم روشن شده و شروع به ثبت اطالعات میکند، و در پایان روز و چند

ساعت بعد از غروب خورشید در وضعیت تاریکی مشابه شروع تست، سیستم خاموش میشود.

اطالعات به صورت لحظهای توسط سریال مانیتور قابل مشاهده میباشد و همچنین می توان

اطالعات ذخیره شده در کارت حافظه را برداشته و جداگانه بررسی کرد.

اطالعات اندازهگیری شده یک شبانه روز تمام سنسورها )از ساعت 4 بامداد تا 10 شب (

در تصویر 34 که به صورت نمودار و در برنامه اکسل رسم شده، آورده شده است.

تصویر -34 نتایج نهایی 16 سنسور

با توجه به اینکه در تصویر 34 اطالعات به وضوح قابل تشخیص نیستند، در ادامه

بصورت انتخابی از بین سنسورها بصورت دو منحنی در کنار هم قرار داده میشود تا قابل

مقایسه با یکدیگر باشند.

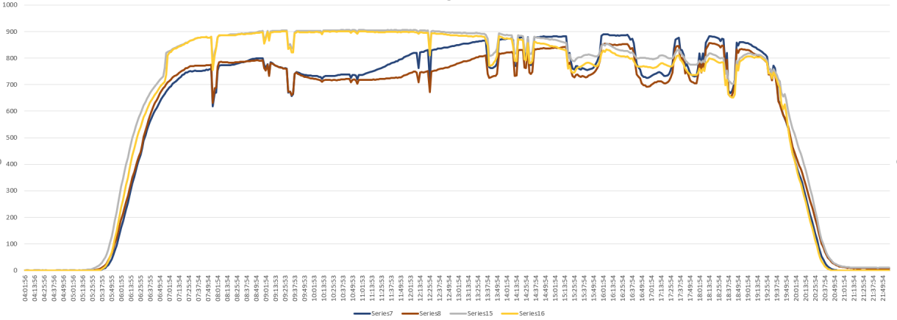
[picture p36: figure]

44

ذکر این نکته ضروری است که این تست در شرق زنجان و در ارتفاع 10 متری از سطح

زمین و در محلی که هیچ سایهای توسط اجسام محیطی در آنجا رخ نمی دهد، انجام شده

است. همچنین قرارگیری سیستم به گونهای است که سنسورهای 15 و 16 تقریبا به سمت

طلوع آفتاب و سنسورهای 7 و 8 به سمت غروب افتاب هستند. در ادامه به مقایسه نمودار

حاصله از اطالعات این سنسورها با یکدیگر میپردازیم.

تصویر -35 نمودار مربوط به سنسورهای 7 و 8 و 15 و 16

با توجه به تصویر ،35 مشاهده میکنیم که نمودار مربوط به سنسورهای 15 و 16 که

رو به سمت طلوع قرار داشتند )منحنی های خاکستری و زرد رنگ( ، در ابتدای روز مقدار

روشنایی بیشتری نسبت به دیگر سنسورها ثبت کردهاند که با گذشت زما ن و تغییر محل

خورشید در آسمان، مقدار روشنایی دریافتی توسط آنها رو به کاهش است. در طرف مقابل

سنسورهای 7 و 8 )منحنیهای آبی و قهوهای( که به سمت غروب خورشید قرار دارند، در

ابتدای روز مقدار روشنایی کمتری را ثبت کردهاند اما با گذشت زمان میبینیم که روشنایی

دریافتی توسط آنها رو به افزایش است.

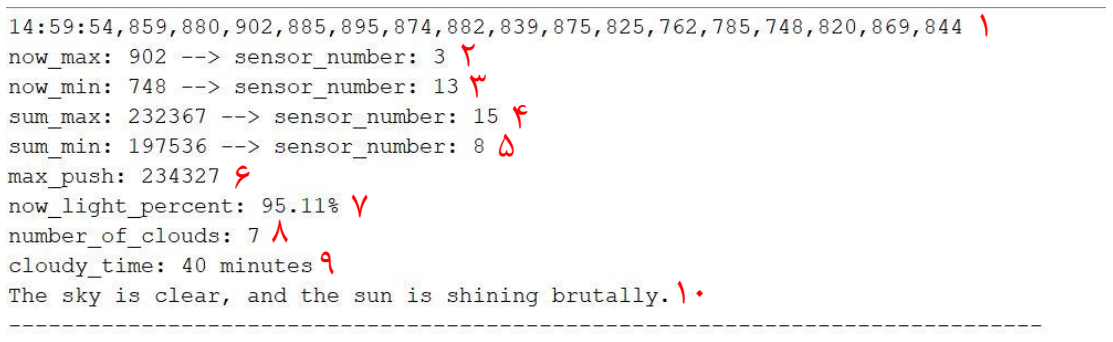
[picture p37: figure]

45

همانطور که در تص اویر 34 و 35 مشاهده میکنیم در زمان هایی مقدار منحنیها به

یکباره کاهش و پس از مدت کوتاهی به مقدار قبلی خود باز میگردند، این بخش ها نمایانگر

زمانهایی است که خورشید پشت ابر قرار میگیرد و سایه کلی بر روی ناحیهای از زمین ایجاد

میشود. همچنین همانطور که مشخص است، روشنایی هوا قبل از طلوع شروع شده و همچنین

در زمان غروب مقداری روشنایی وجود دارد که پس از مدتی به تاریکی کامل میرسیم.

نمونه ای از یک خروجی در سریال مانیتور که مربوط به یک نوبت اندازهگیری است،

در تصویر 36 به نمایش درآمده است که در ادامه به تعریف هر خط آن میپردازیم.

تصویر -36نمونهای از اطالعات نمایش داده شده در سریال مانیتور

-1 زمان دریافت اطالعات و همچنین اطالعات دریافتی در این خط نشان داده شده است.

-2 شماره سنسوری که بیشترین مقدار را در حال حا ضر ثبت کرده است همرا ه با مقدار

آن در این خط نشان داده میشود.

-3 شماره سنسوری که کمترین مقدار را در حال حا ضر ثبت کرده است همرا ه با مقدار

آن در این خط نشان داده میشود.

-4 شماره سنسوری که بیشترین مقدار را از ابتدای فرآیند اندازهگیری ثبت کرده است

همراه با مقدار آن در این خط نشان داده میشود.

46

-5 شماره سنسوری که کمترین مقدار را از ابتدای فرآیند اندازهگیری ثبت کرده است

همراه با مقدار آن در این خط نشان داده میشود.

-6 جمع بیشترین مقادیر در هر نوبت از ابتدای فرآیند اندازهگیری در این خط نشان داده

میشود.

-7 مقدار درصد روشنایی حال حاضر در این خط نشان داده میشود.

-8 تعداد دفعاتی که خورشید پشت ابر قرار گرفته است نشان داده میشود.

-9 مدت زمان پشت ابر بودن خورشید به طور تقریبی محاسبه و نشان داده شده است.

-10 با توجه به اطالعات بدست آمده، وضعیت ابرها و تابش خورشید شرح داده میشود.

نتیجه گیری
اطالعاتی که به صورت time real از طریق سریال مانیتور نمایش داده میشوند،

اطالعات جامع و کاملی از وضعیت فعلی و همچنین ساعات گذشته ارائه میکند. با توجه به

مقادیر max_now و min_now میتوان متوجه شد که در حال حاضر کدام سنسورها

بیشترین و کمترین مقدار از تابش خورشید را دریافت میکنند که میتواند با توجه به شماره

سنسورها و محل قرارگیری آنها در مورد تشخیص محل قرارگیری فعلی خورشید راهنمایی

کند. مقادیر max_sum و min_sum اشاره به سنسورهایی دارند که به ترتیب بیشترین و

کمترین مقادیر روشنایی را از ابتدای شروع روند اندازهگیری دریافت و ثبت کردهاند. محل و

جهت قرارگیری این سنسورها میتواند راهنمایی بسیار خوبی برای شناسایی محل مناسب

برای استقرار و جهت قرار گرفتن پنلهای خورشیدی باشد. هرچه مقدار push_max بیشتر

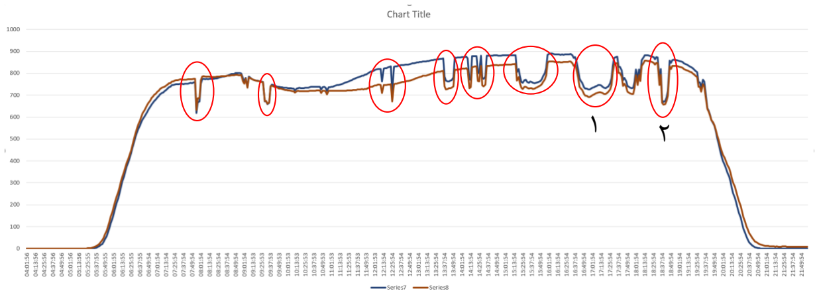
[picture p38: figure]

47

باشد، نشاندهندهی این است که روز پر نور و آفتابی داشتیم. این مقدار با جمع مقادیر ماکزیمم

سریهای اندازهگیری بدست میآید. اگر نقاط ماکیزمم نمودار سنسورها را به هم متصل کنیم،

یک منحنی جدید تشکیل میشود که push_max بیانگر مساحت زیر این منحنی است. با

مقایسه مقادیر push_max حاصل شده از روزهای مختلف میتوان به وضعیت جوی نسبی

آنها پی برد و با یکدیگر مقایسه کرد، واضح است که هرچه این مقدار بیشتر باشد بیانگر هوای

آفتابی و هرچه کمتر باشد بیانگر آسمانی ابری است. تعداد ابرهایی که در مقابل خورشید قرار

گرفتهاند و همچنین زمان محاسبه شده تقریبی این رویدادها نیز میتواند اطالعات مناسبی

دربارهی وضعیت جوی ارائه دهد.

تصویر شماره 36 دو نمودار مربوط به سنسورهای 7 و 8 را که رو به غروب خورشید

بودند را نمایش میدهد.

تصویر -37 نمودار مربوط به سنسورهای 7 و 8

در نگاه اول متوجه فرورفتگیهای یکسان روی هر دو نمودار میشویم. در تصویر شماره

36 این فرورفتگیها با عالمت قرمز مشخص شدهاند. همانطور که در بخش قبل اشاره شد، این

فرورفتگیها برای زمانی است که خورشید پشت ابر قرار میگیرد. با توجه به نوع و شکل این

48

فرورفتگیها میتوان به شدت و مدت زمان ابری بودن هوا پی برد. هر چقدر طول این

فرورفتگیها بیشتر باشد، نشان از طوالنی بودن سایه و بزرگی ابرها خواهد بود. همچنین عمق

فرورفتگیها رابطه مستقیمی با ضخامت ابرها و میزان تاریکی ایجاد شده توسط سایه آنها دارد.

با مقایسه دو فرورفتگیای که با شماره 1 و 2 مشخص شدهاند متوجه میشویم که تقریباً

ضخامت و تاریکی ایجاد شده توسط هر دو ابر یکسان بوده است اما ابری که باعث فرورفتگی

شماره 1 است، بزرگتر بوده و خورشید مدت زمان بیشتری پشت آن قرار داشت. در مناطقی

که ممکن است کل روز هوا ابری باشد، میتوان با مقایسه نمودارهای بدست آمده با روز یا

روزهای قبل آن منطقه که هوا آفتابی بود، به میزان ابری بودن هوا پی برد.

برای یافتن مسیر حرکت خورشید کافی است مشخص کنیم که در هر سیکل جم ع -

آوری اطالعات، بیشترین مقدار دریافت شده مربوط به کدام سنسور است. برای این منظور

میتوان فایل ذخیره شده در کارت حافظه را در برنامه اکسل وارد کرده و سپس از طریق

تابع

1
های موجود بیشترین مقدار هر سطر را که مربوط به اطالعات 16 سنسور در هر سری

اندازهگیری است را به دست آورد تا مشخص شود که مربوط به کدام سنسور است. با متصل

کردن این مقدار ماکزیم م ها میتوان به مسیر تقریبی خورشید پی برد که مسیر خورشید از

سمت چه سنسوری به سمت کدام سنسور حرکت کرده است. واضح است که در مناطق

مختلف مسیر بدست آمده متفاوت خواهد بود. همچنین مسیر بدست آمده در فصول مختلف

از سال از حرکت خورشید در یک منطقه، به دلیل تغییر موقعیت زمین نسبت به خورشید

1 =IF(MOD(ROW();5)=0;CHAR(MATCH(MAX(B1;Q1);B1;Q1;0)+65;””)

49

متفاوت خواهد بود. برای به دست آوردن مسیر دقیق الزم است که تمام سنسورها و

مقاومتهای استفاده شده، دقیق و یکسان باشند.

برای بررسی تغییرات اقلیمی، نیاز است که این اطالعات به طور سالیانه جمعآوری و

ذخیره شده و سپس با یکدیگر مقایسه شوند. این اطالعات برای نتیجه گیری کافی نیستند

بلکه بهتر است در کنار اطالعات دیگری همچون تصاویر ماهوارهای و اطالعات ثبت شده توسط

سازمان هواشناسی بررسی شوند.

برای بدنه، از متداولترین نوع فیالمنت استفاده شده است که عالوه بر کیفیت و

استحکام مناسب، قیمت مناسبی نیز دارد و به راحتی نیز با تمام پرینتر های سهبعدی قابل

پرینت است. نکته قابل توجه در مورد این نوع فیالمنت، عدم توانایی ایجاد تغییرات یا

سوراخکاری پس از پرینت قطعه توسط مته یا دریل است. زیرا در اثر گرمای ایجاد شده توسط

آنها، قطعه در آن ناحیه ذوب شده و تغییر حالت میدهد. با تست طرح در هوای بارانی، آب به

داخل قطعات نفوذی نداشت اما بهتر است برای اطمینان از اسپری های پوششی و یا رنگ

مناسب روی طرح استفاده شود.

از آنجایی که بنا بود آفتاب نگار طراحی شده از هر جهت بهینه باشد، اندازه و حجم

طرح نیز از این قاعده مستثنی نبودند. برای سیستم پردازنده، از کوچکترین عضو خانواده

آردوینو استفاده شد. آردوینو پرو مینی در عین حال که اندازه کوچک و وزن کمی داشت،

تواناییهای الزم جهت رفع نیازهای طرح را نیز دارا بود که قیمت پایین آن، این برد را در

صدر گزینهها برای سیستم پردازنده قرار داد. این نوع آردوینو در دو مدل 3.3 ولت و 5 ولت

50

وجود دارد. اگر منبع تغذیه غالب مدار 5 ولت باشد و قصد استفاده از نوع 3.3 ولتی این نوع

برد وجود دارد، باید از رگوالتور برای کا هش ولتاژ در ورودی منبع تغذیه این برد استفاده شود.

برای اندازهگیری نور محیط سنسورهای مختلفی وجود دارد که سادهترین و ارزانترین

آنها، فوتورزیستورها هستند. با توجه به اینکه در این طرح از تعداد سنسورهای زیادی استفاده

شده است، پس مسئله قیمت سنسورها از اهمیت بیشتری برخوردار است. از طرفی اندازهی

سنسورهای انتخابی نیز مهم است که فوتورزیستورها از این نظر نیز بسیار مناسب و سازگار با

اهداف طرح هستند. چالشی که هنگام کار و استفاده از این نوع سنسورها وجود داشت، متفاوت

بودن حساسیت و تغییرات مقدار دو فوتورزیستور مشابه نسبت به تغییر وضعیت روشنایی

یکسان بود. مشخصه خروجی این نوع سنسور باعث عدم توانایی در کالیبره کردن آنها بصورت

نرمافزاری بود. البته با زیاد کردن تعداد سنسورها و همچنین کوتاه کردن زمان بین دورههای

اندازهگیری، توانستیم تا حدی این مشکالت را پوشش دهیم.

چالش دیگری که در این پروژه وجود داشت، محدوده حساسیت سنسورها به روشنایی

بود. همانطور که در بخش های قبل عنوان شده است، فوتورزیستورها در اصل مقاومت ه ستند

که با تغییر روشنایی پیرامون آنها، مقدار مقاومت فوتورزیستورها نیز تغییر میکند. همچنین

گفته شد که خواندن مقدار سنسورها از طریق تقسیم ولتاژ بین فوتورزیستور و مقاومت 1 کیلو

اهمی صورت میپذیرد. زمانی که روشنایی محیط زیاد شود، مقدار مقاومت فوتورزیستور

کاهش مییابد. محدوده اندازهگیری روشنایی تا جایی است که مقاومت فوتورزیستور به صفر

میل میکند و تمام ولتاژ اعمال شده به پایه آن، در پایه دیگر آن که محل خروجی این

سنسوراست، قرار بگیرد. در این صورت دیگر هر چه مقدار روشنایی محیط بیشتر شود، در

51

خروجی تغییری مشاهده نخواهد شد. برای رفع این مورد می توان از یک فیلتر رنگی بر روی

سنسورها استفاده نمود تا مقدار کلی خروجی سنسورها کمتر شود. با توجه به مشخصه خروجی

غیرخطی از ایجاد فیلترهای برنامهنویسی برای این مورد نمیتوان استفاده نمود.

با توجه به اهداف اولیه تعیین شده برای طرح و همچنین با بررسی اطالعات خروجی

آفتاب نگار طراحی و ساخته شده، می توان به این نتیجه رسید که اهداف مورد نظر تا حدود

مناسبی به وقوع پیوستهاند.

پیشنهادات
-1 با توجه به اینکه فوتورزیستورها نوعی مقاومت با مشخصه خروجی غیرخطی هستند،

عموما برای اهدافی با خروجی صفر و یک مورد استفاده قرار میگیرند که صرفا مشخص

کننده روشنایی یا تاریکی محیط خواهد بود. به منظور اندازهگیری مقدار روشنایی

محیط، برای رسیدن به نتایج عالی، بهتر است از سنسورهای مخصوص اندازه گیری

روشنایی استفاده شود.

-2 برای ثبت و انتقال اطالعات سنسورها، بهتر است از پروتکلهای بیسیم مانند لورا و یا

زیگبی استفاده نمود تا عالوه بر صرفه جویی در زمان، برای آفتاب نگار هایی که در

مناطق غیرشهری قرار دارند کار انتقال اطالعات راحتتر صورت بپذیرد.

-3 همانطور که در فصل دوم عنوان شد، بدنه سیستم طراحی شده از جنس فیالمنت

PLA است. این نوع فیالمنت در برابر تابش شدید خورشید که دمای سطحی آن را به

باالی 60 درجه سلسیوس ببرد مقاوم نبوده و تغییر شکل میدهد. پیشنهاد میشود

52

برای استفاده از این دستگاه در مناطق گرمسیر که با تابش شدید خورشید همراه است،

برای بدنه از جنس رزین که دارای مقاومت باالیی در برابر گرما و ضربه است، استفاده

شود.

-4 برای اینکه یک پردازنده مط م ئن از هر نظر داشته باشیم، بهتر است از میکروهای

خانواده ARM استفاده کنیم.

-5 با توجه به تعداد باالی سنسورها و اهمیت اتصال درست و بی نقص این سنسورها به

مقاومت ها و منابع تغذیه، بهتر است یک برد PCB طراحی شده و پایه سنسورها و

مقاومت ها روی برد به یکدیگر متصل شوند تا عالوه بر اتصال درست، هرگونه تعمیر و

تعویض در صورت نیاز نیز به خوبی صورت بگیرد.

-6 میتوان سنسورهای دیگری مانند سنسور سنجش نور فرابنفش، سنسور اندازهگیری

دما و ... را نیز به این طرح در جهت تایید و تکمیل اطالعات دریافتی سنسورهای اصلی

اضافه نمود.

-7 برای مواقعی که ممکن است برق اصلی دستگاه قطع شود، بهتر است یک منبع تغذیه

پشتیبان جهت ادامه ثبت اطالعات و همچنین اطالع رسانی تعبیه و در نظر گرفته

شود.

البته ذکر این نکته ضروری است که با اعمال هر کدام از پیشنهادات ذکر شده، هزینه نهایی

سیستم افزایش چشمگیری خواهد داشت.

53

### مراجع

1- https://en.wikipedia.org/wiki/Campbell–Stokes_recorder 2- https://en.wikipedia.org/wiki/Pyranometer
3- https://www.mrfilament.com/guide/%D9%81%DB%8C%D9%84%D8%A7%D9%85%D9%86%D8%AA-abs/ (https://www.mrfilament.com/guide/%D9%81%DB%8C%D9%84%D8%A7%D9%85%D9%86%D8%AA-abs/)
4- https://store.arduino.cc/usa/arduino-pro-mini
