mrezamostafavi/Sunshine-Recorder/wiring_diagram.png

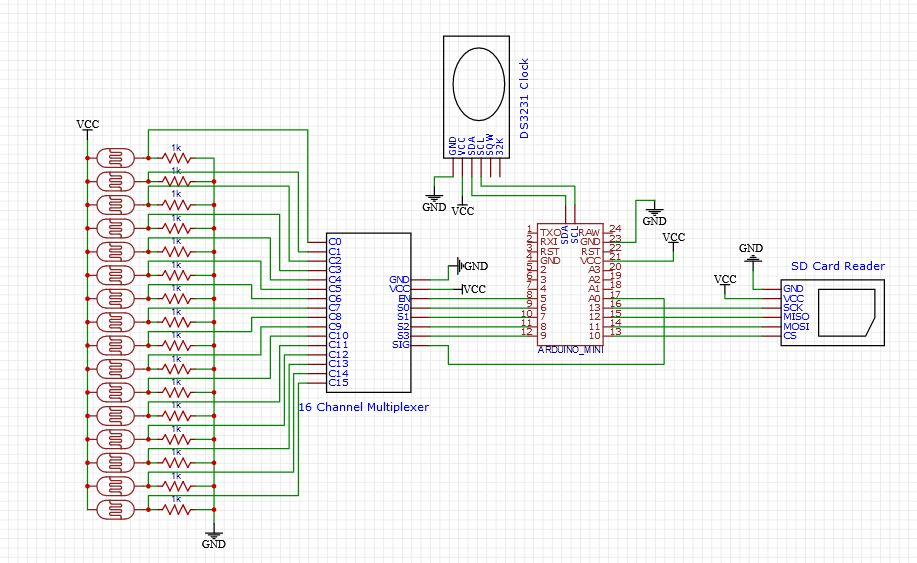
wiring_diagram.png
